radionerd/VirtualPipeOrgan/MidiFirmware/BlockDiagram.odt

USB Midi HID / Keyboard Serial 8 x 16 Matrix Scan Shift Reg I/F I2C ADC x 8 16x2 LCD Display 16x2 LCD Display Shift Register IF to Illuminated Pushbuttons 8 Op per s/r. 12 x s/r’s or More Scan up to 8 out x 16 in Diode Matrix for keyboard, Pedal board or Non-illuminated contacts Up to 8 Potentiometers for expression pedals and other analogue controls STM32F103C8T6 Blue Pill

Up to

8 Displays
