radionerd/VirtualPipeOrgan/ConsoleDrawings/PistonLabels.odt

This page is for printing onto a transparent sheet, cut labels to 12 x 12mm.

Div’n | 1 | 2 | 3 | 4 | 5 | 6 | 7 | 8 | 9 | 10 | 11 | 12 | 13 | 14
DISP. LHS | P/III | P / II | P / I | STEP -100 | STEP +100 | STEP -10 | STEP +10 | STEP +1 | STEP -1 | STEP xx0 | STEP xx1 | STEP xx2 | STEP xx3 | STEP xx4
DISP. RHS | STEP xx5 | STEP xx6 | STEP xx7 | STEP xx8 | STEP xx9 | | | | | STEP 000 | CURR -ENT | MUSIC STAND | PEDAL LAMP | SHIFT
III RHS SWELL | START REC | START PLAY | STOP REC | STOP PLAY | | | | | III/I | II/I | III/P | II/P | I/P | III/II
III LHS SWELL | Tutti | GEN 6 | GEN 7 | GEN 8 | GEN 9 | GEN 10 | 1 | 2 | 3 | 4 | 5 | 6 | 7 | 8
II LHS GREAT | | | | | | GEN 1 | GEN 2 | GEN 3 | GEN 4 | GEN 5 | 1 | 2 | 3 | 4
II RHS GREAT | 5 | 6 | 7 | 8 | | PREV | NEXT | | PED 6 | PED 7 | PED 8 | PED 9 | PED 10
I LHS CHOIR | SET | Metro nome On/Off | BBAR -1 | BBAR +1 | BPM +10 | BPM -10 | BPM -1 | BPM +1 | | | 1 | 2 | 3 | 4
I CHOIR POSITIV | 5 | 6 | 7 | 8 | GEN CAN | PAGE < | PAGE > | | PED 1 | PED 2 | PED 3 | PED 4 | PED 5 | GENERAL CANCEL

Keyboard Button Layout

Division | 1 | 2 | 3 | 4 | 5 | 6 | 7 | 8 | 9 | 10 | 11 | 12 | 13 | 14 | 15 | 16 | 17 | 18 | 19 | 20 | 21 | 22 | 23 | 24 | 25 | 26 | 27 | 28 | 29 | 30
18 | 7 Seg Display | | | LCD 1 | | | STEP +100 | STEP +10 | STEP +1 | STEP 000 | STEP XX0 | STEPXX1 | STEP XX2 | STEP XX3 | STEP XX4 | STEP XX5 | STEP XX6 | STEP XX7 | STEP XX8 | STEP XX9 | Curr-ent | Music Stand | Pedal Lamp | SHIFT | LCD 2 | | | LCD 3
SOLO/ BOMBARDE
III SWELL 19 | | | SHIFT | Wired to Disp 7 | Tutti | Wired to Disp 8 | BBAR +1 | BPM +10 | BPM +1 | Metro nome OnOff | | 1 | 2 | 3 | 4 | 5 | 6 | 7 | 8 | | | | III/I | II/I | III/P | II/P | I/P | III/II
II GREAT 21 | | | START REC | STOP REC | | GEN 6 | GEN 7 | GEN 8 | GEN 9 | GEN 10 | | 1 | 2 | 3 | 4 | 5 | 6 | 7 | 8 | | PREV | NEXT | | PED 6 | PED 7 | PED 8 | PED 9 | PED 10
I CHOIRPOSITV 22 | SET | | START PLAY | STOP PLAY | Wired to Set | GEN 1 | GEN 2 | GEN 3 | GEN 4 | GEN 5 | | 1 | 2 | 3 | 4 | 5 | 6 | 7 | 8 | | PAGE - | PAGE + | Wired to Genral Cancel | PED 1 | PED 2 | PED 3 | PED 4 | PED 5 | | Genral Cancel
PCB | 1 | | 1 | 2 | 3 | 4 | 5 | 6 | 7 | 8 | | 1 | 2 | 3 | 4 | 5 | 6 | 7 | 8 | | 1 | 2 | 3 | 4 | 5 | 6 | 7 | 8 | | 3?

Button Count

Display Panel 18+

Division III 20 = 5 shift registers

Division II 22 = 3 shift registers

Division I 24 = 3 shift registers

84 Buttons, 11 shift registers (4 unused button positions)
