radionerd/VirtualPipeOrgan/PCBs/MidiInterfaceAll/MidiInterface.jpg

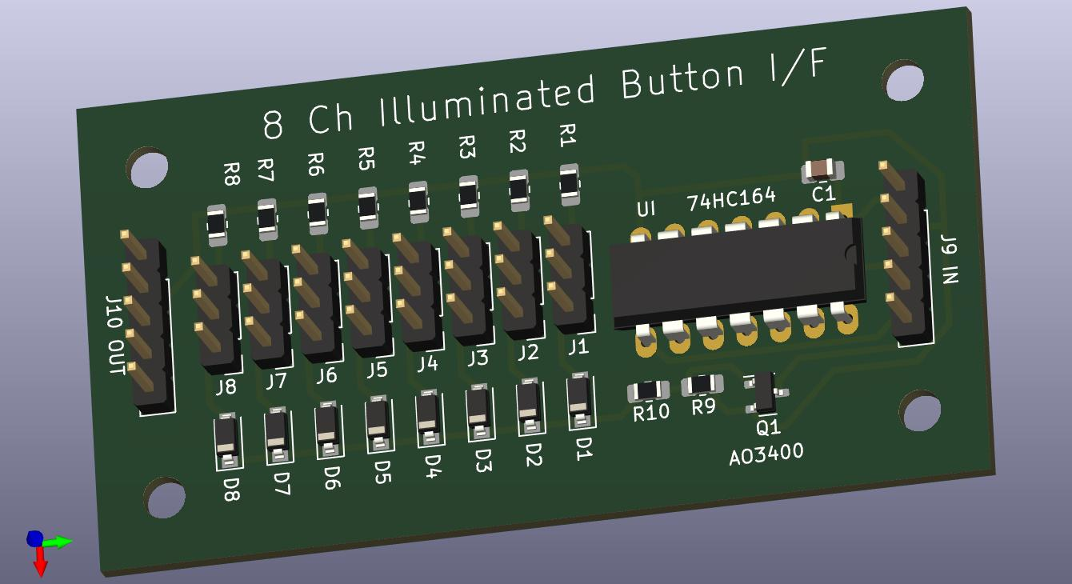
PCBs/MidiInterfaceAll/MidiInterface.jpg
