radionerd/VirtualPipeOrgan/ConsoleDrawings/test.dxf

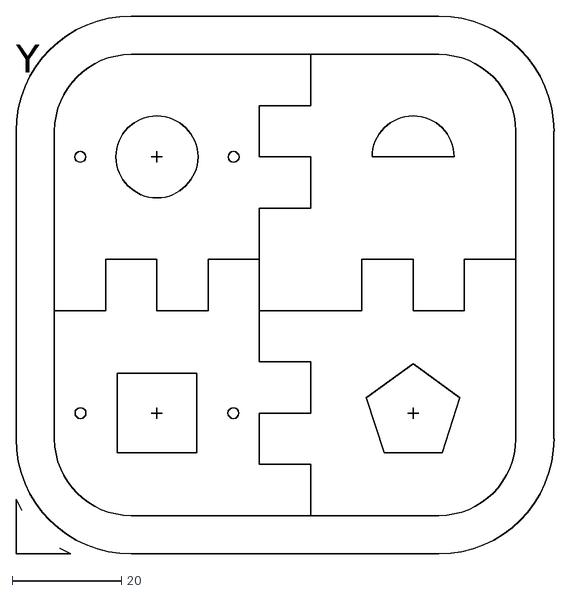
[picture p3: CAD file, 2025-04-20]
ConsoleDrawings/test.dxf
Y
