radionerd/VirtualPipeOrgan/ExpressionPedal/Foot Pedal Geometry.dxf

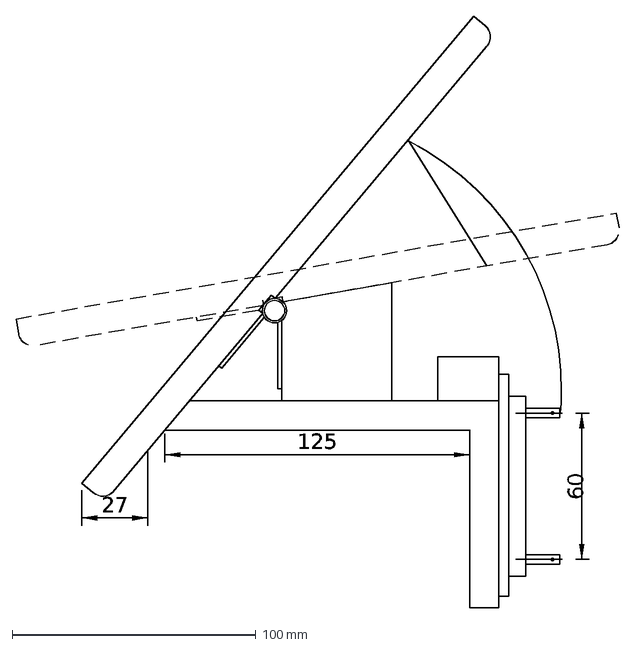
[picture p4: CAD file, 2025-04-21]
ExpressionPedal/Foot Pedal Geometry.dxf
60
125
27
