radionerd/VirtualPipeOrgan/ConsoleDrawings/musicStand.dxf

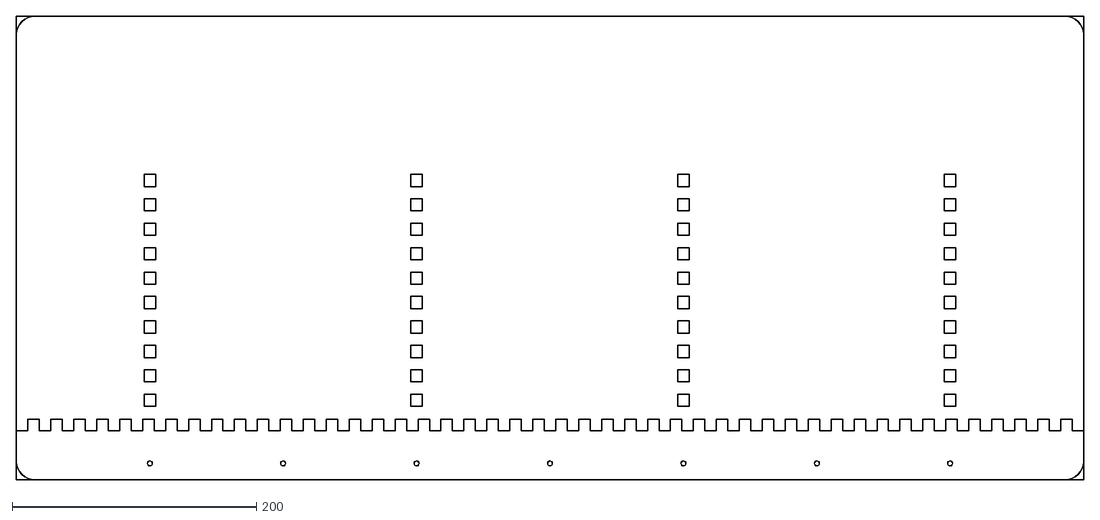
[picture p5: CAD file, 2025-04-20]
ConsoleDrawings/musicStand.dxf
873.7 x 379.4
