radionerd/VirtualPipeOrgan/ExpressionPedal/Foot Pedal Drilling and Cutting.dxf

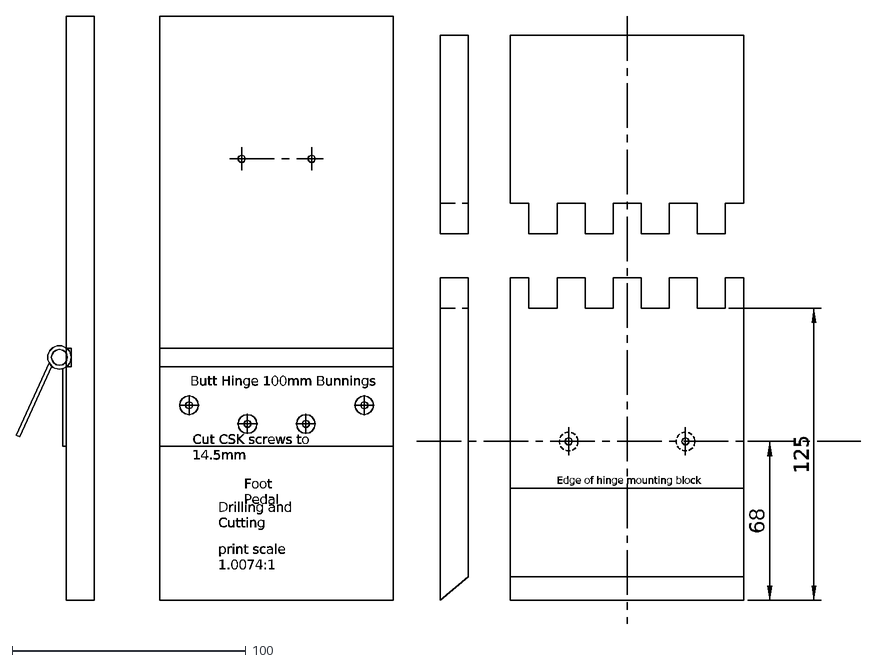
[picture p6: CAD file, 2025-04-21]
ExpressionPedal/Foot Pedal Drilling and Cutting.dxf
Butt Hinge 100mm Bunnings
Foot Pedal
print scale 1.0074:1
Cut CSK screws to 14.5mm
Drilling and Cutting
Edge of hinge mounting block
68
125
