radionerd/VirtualPipeOrgan/ConsoleDrawings/trayIII.dxf

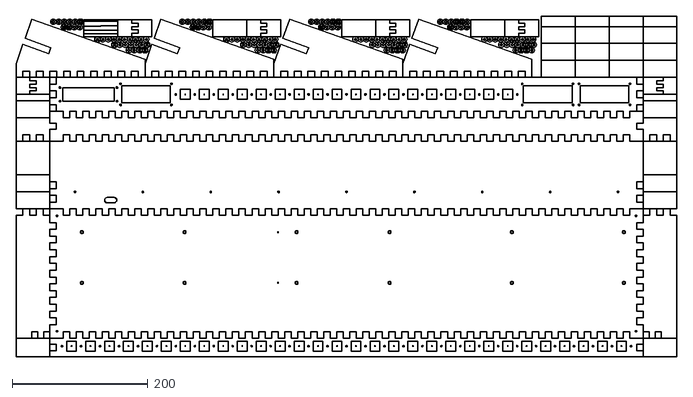
[picture p7: CAD file, 2023-09-29]
ConsoleDrawings/trayIII.dxf
973.7 x 501.4
