radionerd/VirtualPipeOrgan/ExpressionPedal/#PrototypeJig.dxf

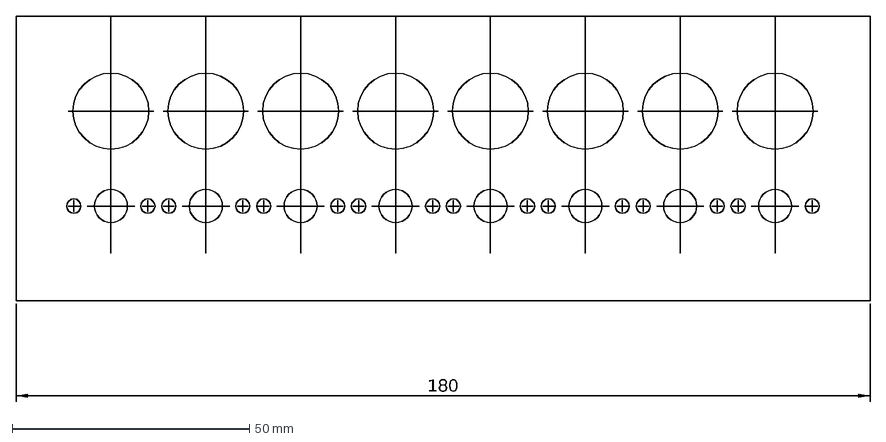
[picture p8: CAD file, 2025-04-21]
ExpressionPedal/#PrototypeJig.dxf
180
