radionerd/VirtualPipeOrgan/ConsoleDrawings/trayII.dxf

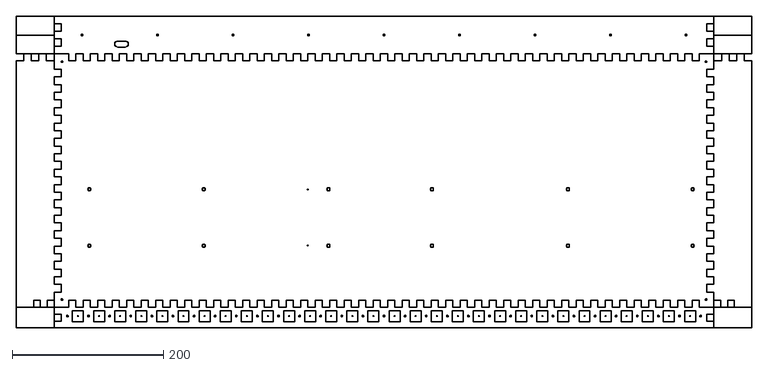
[picture p9: CAD file, 2023-09-29]
ConsoleDrawings/trayII.dxf
973.7 x 412.7
