radionerd/VirtualPipeOrgan/ConsoleDrawings/trayI.dxf

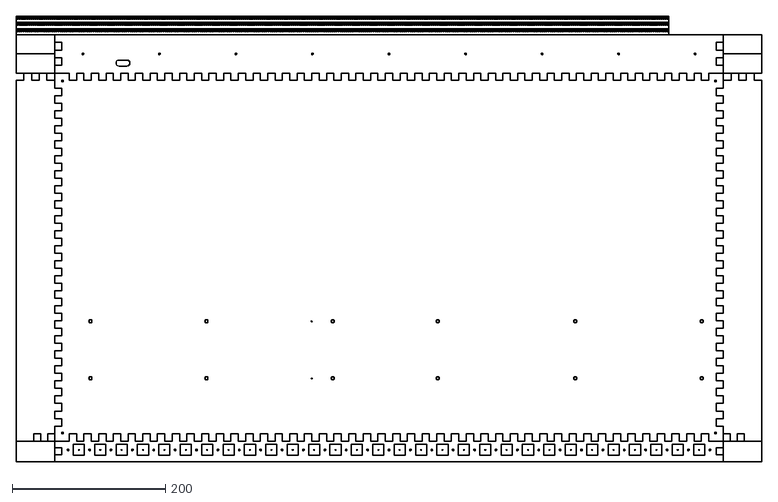
[picture p10: CAD file, 2023-09-29]
ConsoleDrawings/trayI.dxf
973.7 x 581.9
