radionerd/VirtualPipeOrgan/ConsoleDrawings/tray444.dxf

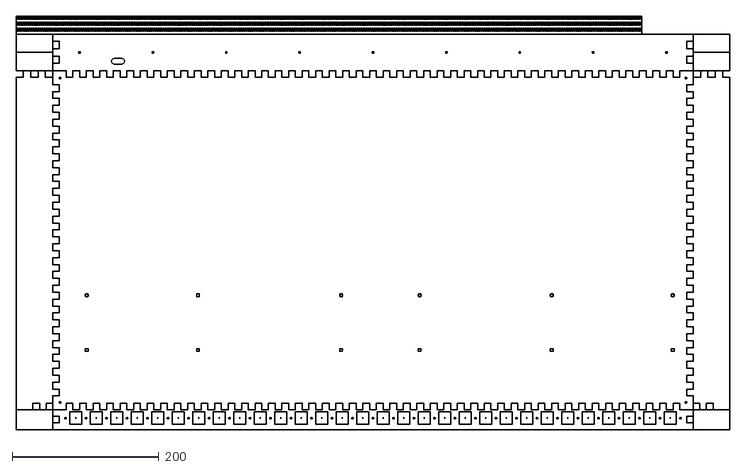
[picture p11: CAD file, 2023-08-24]
ConsoleDrawings/tray444.dxf
973.0 x 563.2
