radionerd/VirtualPipeOrgan/(list of files, cad)

Other CAD files:
ExpressionPedal/PrototypeJig.dxf
