radionerd/VirtualPipeOrgan/MidiFirmware/UserManual.md

# USB MIDI Interface User Manual

This user manual uses Linux OS examples with Grandorgue. For other Operating Systems and Applications similar commands will exist. 

The user manual assumes that you have programed the flash in the STM32 Bluepill using the instructions in [README.md](https://github.com/radionerd/VirtualPipeOrgan/blob/main/MidiFirmware/README.md)

## Features
- Hosted on the Arm Cortex-M3 CPU STM32F103C8T6 Bluepill, a ~$2 US development board
- USB Connection to host computer, LED blink on MIDI activity
- Multiple STM32 boards may be deployed to ease wiring
- Scanning for MAudio Keystation 61 Keyboard or 32 note pedalboard
- Up to 4 ADC inputs when configured for a keyboard without velocity sensing
- Up to 8 ADC inputs for expression pedals when scanning a pedalboard
- 64 LED illuminated button inputs using external 74HC164 shift registers
- One 6 digit LED display per MIDI controller (for combination setter & crescendo display)
- Multiple Liquid Crystal Display modules 16x2 line PCF8574 I2C interface ( 8 per IC type )
- Interface to WS2812 RGB LED string for music stand or pedal illumination
- USB HID (qwerty keyboard) messages for music page turning
- Simulated serial interface over USB for viewing/saving configuration in Flash
- Tested using Arduino V1.8.19 with STM32 extensions under Ubuntu 24.04 X86 & Arm Linux
- Printed circuit boards to mount the STM32 Bluepill and shift register interfaces use low cost plug in cables to simplify wiring

## The USB Connection

To discover whether the MIDI interface is successfully connected to the computer type 'lsusb' at the command prompt. The MIDI interfaces and the configured MIDI channel numbers for keyboard/pedalboard, and the illuminated buttons should show up in the response. e.g:
```
$ lsusb
   ...
   Bus 001 Device 094: ID 1eaf:0031 Leaflabs VPO Console MIDI Ch3, 11
   Bus 001 Device 095: ID 1eaf:0031 Leaflabs VPO Console MIDI Ch4, 12
   ...
```

## MIDI Channel Assignment

MIDI channels for keyboard/pedalboard are configurable from 1-8 with the illuminated button channel offset by 8.

e.g. If the pedalboard MIDI channel is set to 4, then the Button MIDI channel will be 4 + 8 = 12.

## MIDI Messages

|  Control |Chan| MIDI Message  | Direction |
|:---:|:--:|:---:|:---:|
| Keyboard |1-8 | MIDI Note 32-96 | To Comp |
| Pedalboard |1-8 | MIDI Note 32-64 | To Comp |
| Expression |1-8 | MIDI CC 20-27 | To Comp |
| Buttons |9-16| MIDI Note 0-127 | To Comp |
| Button LEDs|9-16| MIDI Note 0-127 | From Comp |
| LED 7Seg |N/A | SysexID as KChan| From Comp |
| LCD Display|N/A | MIDI Sysex 32-63| From Comp |

ID addresses are shown on the LCD and 7 Segment LED displays after power up.

### Power Up

At power up the MIDI interface loads the 7 Segment display, LCDs with the 'PC Comms' message and lights the Push Button LEDs until PC communication is established over the USB. Then the displays are loaded to show their configured addresses. The 7 Segment Display configured address is the same as the MIDI channel number. 

|  State | 7Seg Text  | LCD Text | LED Push Buttons  |Built In LED  |
|:---:|:---:|:---:|:---:|:---:|
|Power On  | PC ??? | PC Comms ??? | All Lit | Flash |
|PC Success|  Add= 3 |VirtualPipeOrgan| Light When Pressed|Breathing .5Hz|
| " " | |i2cAddr=37  0x25| | ADC Toggle |
|GrandOrgue| GO | GO | GO | Note: On/Off |

The MIDI Interface LED will flash during initialisation. When communication with the PC is established the MIDI Interface LED will slowly get brigter and dimmer at approx 0.5Hz to show that all is well.

When Keyboard or Push button are pressed or released the MIDI Interface LED will turn on of off in sync, and resume 0.5Hz breathing after 5 seconds of inactivity. The Builtin LED also toggles on or off when MIDI CC messages are sent by the ADC.

Until GranOrgue is running push button LEDs illuminate when pressed as a button and LED test feature.

Once GrandOrgue is running the push button LEDs may be loaded by GrandOrgue MIDI note on or MIDI note off messages, the value field 0-127 is ignored.

# Monitoring MIDI Messages on the PC
Use 'midisnoop' to monitor messages sent between the keyboard/pedalboard and the computer. Select Alsa unless you have Jack configured.
```
$ midisnoop &
```
MIDI messages may also be monitored within the MIDI Interface using the 'J' command (see below).

# Making MIDI Connections
Use 'qjackctl' graph function to view or connect MIDI outputs to MIDI inputs.

This works for ALSA and JACK.

```
$ qjackctl &
```
At startup GrandOrgue makes its required MIDI connections to the MIDI keyboards.

You may need to re-esatblish connections manually if you restart the STM32 Bluepill.

Connect the Grandorgue output to VPO Console and midisnoop inputs using the qjacktctl graph feature and mouse.

Connect the VPO Console output to Grandorgue and midisnoop inputs using the qjacktctl graph feature and mouse.

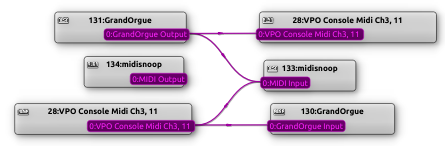
[picture p12: MidiFirmware/MidiSnoopGOExample.png]


Alternatively edit and run the [autoconnect](https://github.com/radionerd/VirtualPipeOrgan/blob/main/MidiFirmware/autoconnect) script in background.

## Configuring the Firmware
A simulated USB serial connection is used to communicate with the MIDI Interface.
Connect one STM32 BluePill to the computer using a USB cable.
Install 'minicom' and configure it to connect to /dev/ttyACM0 or /dev/ttyUSB0 depending on your OS.
( Exit minicom by typing CTRL+A Z Q <Enter> )
To confirm that you have the expected MIDI channel and tty device run the command:
```
 $ ll /dev/serial/by-id/
total 0
drwxr-xr-x 2 root root 80 Jun  1 13:53 ./
drwxr-xr-x 4 root root 80 Jun  1 13:53 ../
lrwxrwxrwx 1 root root 13 Jun  1 13:53 usb-New_Zealand_VPO_Console_Midi_Ch3__11_00001-if02 -> ../../ttyACM1
lrwxrwxrwx 1 root root 13 Jun  1 13:53 usb-New_Zealand_VPO_Console_Midi_Ch4__12_00001-if02 -> ../../ttyACM0

```
Once connected successfully expand the minicom window and press the spacebar.
You should see a display that shows which pin functions are assigned.
Configure what you require using the A-J keys, then press 'S' to save.
```
STM32 Blue Pill Assigned Pin Functions
IP_SR_DATA    PB12   USB   GND    
Scan In  0    PB13         GND    
Spare         PB14         3V3    
Scan In  2    PB15         NRST   
Spare         PA_8         PB11   OP_SR_CLOCK
Scan In  4    PA_9         PB10   TM1637_CK
Spare         PA10         PB_1   Scan In  8
USB-          PA11         PB_0   IP_ADC  6
USB+          PA12         PA_7   Scan In  a
Scan In  6    PA15         PA_6   IP_ADC  4
Spare         PB_3         PA_5   Scan In  c
Scan Out 4    PB_4         PA_4   IP_ADC  2
Scan Out 5    PB_5         PA_3   Scan In  e
LCD  I2C_SCL  PB_6         PA_2   IP_ADC  0
ShareI2C_SDA  PB_7         PA_1   Scan Out 3
Scan Out 6    PB_8         PA_0   Scan Out 2
Scan Out 7    PB_9         PC15   Scan Out 1
               +5V         PC14   Scan Out 0
               GND         PC13   OP_LED
               3V3 | | | | VBAT   
                   | | | |
WS2812 LEDs   PA13---+ +---PA14   HID PageTurn
BOOT1         PB_2 (on Jumper via 100K resistor)

Configuration Menu
A [3] Key/Pedal MIDI Channel=3, Button channel=11
B [ ] Pedalboard
C [4] Number of ADC Inputs PA2-PB1
D [ ] Keyboard/Pedalboard Velocity Reporting
E [✓] PCF8574 I2C LCDs 16x2 Line
F [✓] TM1637 7 segment, 6 digit display
G [1] 74HC164 Button LED Normal+Backlight
H [✓] Page Turning
I [✓] WS2812 RGB LED Strip
J [ ] Event Log to USB Serial (may slow response time)
Cfg.Word=CE42
Enter A-L,a-l To adjust cfg value, S to Save, ? - Menu:
```
The event log 'J' command is useful to monitor MIDI messages being sent to the computer. However
using the event log may slightly slow down performance and so should not be enabled during normal use.

# MIDI Interface Menu

To monitor activity on attached devices type '?' to view the MIDI interface menu.
```
MIDI Interface Menu
@ - or spacebar to View Configuration
A-J Adjust configuration value
K - Keyboard Contacts
L - LCD 'l'=view, 'L'=load
M - Flash memory summary
O - Shift Register IO
P - Profile
R - Restore Configuration
S - Save New Configuration
T - Test IO Pins
U - USB HID Page Turn Input
V - Version Info
W - WS2812 LED Strip
X - eXpression Pedal / ADC results
Z - Pin Status
```
Single letter commands are used to configure the MIDI interface and to view the status of connected hardware. The the configuration has been changed the 'S' Save command should be used to store the new configuration in Flash memory.

### MIDI Channel Selection

The 'A' command is used to select select the MIDI keyboard channel 1-8 and the corresponding LED Button channel offset by 8.

### Keyboard or Pedalboard

The MAudio Keystation 61 note keyboard connectors are accomodated directly on the PCBs.
The keyboard provides two contacts per note for velocity sensing between the time that the first and second contact operates or releases.
When Velocity sensing is not required, four unused inputs become available for ADC/Expression inputs if required.
When pedalboard operation is selected the same keyboard note assignments are used, so the MAudio Keystation may be used to emulate a pedalboard for testing.

The 'B' command toggles  between Keyboard or Pedboard configuration. The 'D' command enables/disables velocity sensing.

### 'K' Keyboard scan result.
The MAudio Keystation 61 Mk3 music keyboard has two contacts per key to sense velocity. Keyboard scanning uses 8 outputs and 16 inputs. When pedalboard is selected the top 8 keyboard input lines are re-assigned to be used as expression pedal (ADC) inputs. The pedalboard scans 32 contacts using 8 outputs and 8 inputs. Alternate inputs are unused when there is no velocity sensing.
```
Keyboard Scan Result MIDI Channel 3

0000000000000000 OP0  CN13 PIN4
0000000000000000 OP1  CN13 PIN3
0000000000000000 OP2  CN13 PIN2
0000000000000000 OP3  CN13 PIN1
0000000000000000 OP4  CN14 PIN4
0000000000000000 OP5  CN14 PIN3
0000000000000000 OP6  CN14 PIN2
0000000000000000 OP7  CN14 PIN1
........******** IP *=CN13 input pins 5-6,7=nc,8-13
********........ IP *=CN14 input pins 5-12
```
When the keyboard contacts are operating correctly use the 'J' command to check the MIDI messages being sent to the PC.

## Liquid Crystal Displays

The LCDs use PCF8574 based I2C to parallel adapters.



The PCF8574 and PCF8574A ICs on LCD displays use two different address ranges.

Unless you need more than 8 displays it does not matter which kind you buy or whether they are mixed.

|  PCF8574 | Grandorgue | PCF8574A | Grandorgue | A2| A1| A0|
|:---:|:---:|:---:|:---:|:-:|:-:|:-:|
| 0x20 | 32 | 0x38 | 56 | 0 | 0 | 0 |
| 0x21 | 33 | 0x39 | 57 | 0 | 0 | 1 |
| 0x22 | 34 | 0x3a | 58 | 0 | 1 | 0 |
| 0x23 | 35 | 0x3b | 59 | 0 | 1 | 1 |
| 0x24 | 36 | 0x3c | 60 | 1 | 0 | 0 |
| 0x25 | 37 | 0x3d | 61 | 1 | 0 | 1 |
| 0x26 | 38 | 0x3e | 62 | 1 | 1 | 0 |
| 0x27 | 39 | 0x3f | 63 | 1 | 1 | 1 |

The ID adddresses configured in GrandOrgue are Base 10.

- User solder bridges A0-A2 are used to program zeros and are binary coded. So the default address without any solder bridges is is either 0x27 (39) or 0x3F (63).

The content of the LCD messages may be viewed with the 'l" command, and LCDs may be loaded with the 'L' command.

## Seven Segment, Six Digit LED Display



Some TM1637 LED Display modules ship with excessively large value filter capacitors on Data and Clock inputs. The capacitors not only prevent the seven segment display updates, but also disrupt I2C LCD Display and button shift register operation. If fitted, these filter capacitors need to be either removed or significantly reduced in value.

The 'l' Command also displays the status of the Seven Segment TM1637 LED display.

```
LCD Display List                                                                
Dec  Hex Text                                                                   
 03 0x03 [Add=3 ][]                                                             
 37 0x25 [VirtualPipeOrgan][i2cAddr=37  0x25]                                   
 62 0x3E [VirtualPipeOrgan][i2cAddr=62  0x3E]                                   
 63 0x3F [VirtualPipeOrgan][i2cAddr=63  0x3F]                                   
```

### 'M' Flash Memory Summary
Not really a user feature.  Provided for testing the 'S'ave command.
```
Flash Memory Summary

0800C850 0000 0000 0000 0000 0000 0000 A678 0800
0800C860 FFFF FFFF FFFF FFFF FFFF FFFF FFFF FFFF
...
0801F7F0 FFFF FFFF FFFF FFFF FFFF FFFF FFFF FFFF
0801F800 DEAD 7F58 0000 1000 1E00 1E01 1E03 1E02
...
0801F820 BE72 3E12 3E02 FFFF FFFF FFFF FFFF FFFF
0801F830 FFFF FFFF FFFF FFFF FFFF FFFF FFFF FFFF
...
```
### LED Illuminated Push Buttons

LED lluminated push buttons are connected via 74HC164 shift registers. LEDs may be configured by the 'G' command to light normally or inverse and to have a dim backlight which is useful for reading the button legends in a dim environment.

When the MIDI interface powers up all LEDs light briefly as a lamp test feature.

Until the MIDI Interface connects to GrandOrgue each button will illuminate when pressed for testing the button and LED operation.

Once GrandOrgue is running the push button LEDs may be loaded by GrandOrgue 'MIDI note on' or 'MIDI note off' messages, the value field 0-127 is ignored.

Buttons generate MIDI note messages on the configured keyboard MIDI channel plus 8.

The first button (00) in the series acts as a shift key. When button 00 is held in, any other button pressed generates its MIDI note +64. The shift feature may be used to economise on the number of console buttons. For example a '+1' button may be configured to act as '-1' when shift is pressed.

When a button is held for longer than 4 seconds its MIDI note is set to auto repeat at 0.5 second intevals. Auto repeat may be useful for adjusting the metronome tempo.

The status of the connected shift registers may be seen with the 'O' command.

```
Shift Register MIDI Channel 12 Note Numbers

SR 1   00  i01o  02   03   04   05   06   07  
SR 2   08   09   10   11   12   13   14   15  
SR 3   16   17   18   19   20   21   22   23  
SR 4   24   25   26   27   28   29   30   31  
SR 5   32   33   34   35   36   37   38   39  
SR 6   40   41   42   43   44   45   46   47  
SR 7   48   49   50   51   52   53   54   55  
SR 8   56   57   58   59   60   61   62   63  

i = input on, o = output on
```
The power 'ON' indicator of the GrandOrgue 'Master Controls' panel may be configured with a mouse right click to send the power on status the the shift button (MIDI-note 0) LED. In this way it can be seen at a glance when the organ is ready to play.

### Profile

The 'P' command displays the execution times in microseconds of different features in use. This is a development feature to ensure that the system is always responsive with no excessive time delays. Lower case 'p' displays executions times, upper case 'P' clears the recorded times to zero.
```
Times in microseconds

   Count Interval AvgTime MaxTime  Feature
  344903     1001      59     116  Music Keyboard
   34491    10000       2    7645  SerialUI
   34490    10000       3       9  ADC
   34490     9999     541     624  Buttons
   34490    10002       6       8  HID PageTurn
   34490    10000       3    5014  MIDI Poll
   34490    10000       5    1698  WS2812 LED Strip
      15     9594      87    4511  Sysex
       1  9999999    1369    1369  MIDI Out to SysEx In
  344902      999      63    7711  Loop
       8  9999999    2032    2083  This Print
       0        0       0       0  Spare
```
It seems as though MIDI send execution times are longer when GrandOrgue is not connected.

The profile feature was used in conjunction with an oscillscope to reduce execution times by :

- Coding direct GPIO access in lieu of Arduino GPIO ( making the firmware much less portable )
- Keyboard and Button scanning using STM32 Bit-Banding
- Active pull down of keyboard scan lines ( briefly driving active inputs low rather than using pull down resistors )
- Sending only changes to LCD displays ( the largest saving of all 40+ms to sub millisecond in some cases )

Execution times for WS2812 LED strips are incorrect, as one timer interrupt is missed during loading.

### Test GPIO Pins

the 'T' command provides a simple check that each GPIO pin may be briefly driven high and low and read back correctly. It can by handy to isolate faulty boards.

### Page Turning

The page turning feature is intended to control the display of music shown on the computer monitor using a pdf file viewer such as Evince.

The page turning feature uses the USB Human Interface Device (HID) protocol and appears to the PC as a keyboard.

The MIDI interface sends four QWERTY keyboard commands on the USB cable from a single switch depending on how the switch is pressed. The MIDI interface simulates the pressing of keys, just as though they were entered on the computer keyboard. Page turning will be successful when the file viewer has focus and responds appropriately to the 'Page Up', 'Page Down', 'Home' and 'End' keys.

eg To send 'Page down' one short press.
eg To send 'Home' long press after single presses.
eg To go back one page, two short presses.
A single press followed by a long press will scroll through the entire document forwards.
A double press followed by a long press will scroll through the entire document backwards.

| Short Count | Short Press |  Long Press | Long Repeat |
|:---:|:---:|:---:|:---|
| 1 |  Page Down  |  Ctrl+Home  |  Page Down  |
| 2 |  Page Up |  Ctrl+End |  Page  Up |

On a good day single short and long presses should be sufficient to work through the music and go back to the beginning.

An off the shelf sustain pedal may make a useful page turning switch.

The page turning switch is attached between 0v and PA14 located on the Debug/Programming connector.

Page turning is configured using the 'H' and 'S' commands, and its status viewed using the 'U' command.

<mark> Note ! </mark> When using the Virtual Serial Port and minicom with the USB HID Page turn feature remember to move the PC window focus away from minicom to, for example, a pdf file viewer. Otherwise minicom will respond to the page control commands.

Page Turning execution time is 20ms for Page Down, and 40ms for Page Up. So turning pages may very slightly delay keyboard notes.

### Version Info

The Version number and compilation date are reported with the 'V' command. e.g.

```
V0.9.1 Jun 15 2025 21:08:47
```

### ADC & Expression Pedals

Up to 8 ADC inputs may be configured for Expression Pedals when the Pedalboard option is selected.

Up to 4 ADC inputs may be configured for Expression Pedals when the Keyboard option is selected without velocity sensing.
Select the number of ADC convertors to use using the 'C' command.
Note. ADC inputs are connected to potentiometers wired between 0v and 3.3V with a 470R resistor connected between the wiper and the MIDI interface input pin. 
Enabling A->D conversion without any connected input may generate large amounts of meaningless MIDI CC messages slowing down the system.

On GrandOrgue right click on the expression pedal input. 

Click 'Event' and select Bx Controller

Click 'Channel' select your configured MIDI channel

Click 'Detect Complex MIDI Setup', move the Expression Pedal control as directed.
Note: The MIDI interface generates CC messages in the range 20-27

Click 'OK' and remember to save the organ settings

Use the 'X' command to view the Expression pedal status. e.g.
```
Expression Pedal/ADC Results
    ADC   AVG   REP MIDICh CCommand
0  2592  2589    80     4    20
2   161   155     4     4    22
4   160   157     4     4    24
6   150   157     4     4    26
```

### WS2812 LED strip

The LED feature is intended for illuminating music stands and pedalboards.

The LED strip is controlled by pressing the lowest C# on the MIDI controller to which the LED strip is connected. The C# is only active for LED control when no other notes have been active for the previous 5 seconds. The number of key presses will trigger different functions

| | Short Press | Long Press |
|:-:|:---:|:---:|
| 1 | Toggle On/Off |Brightness  |
| 2 | Rainbow mode  |Colour(Hue) |
| 3 | |Saturation  |

Strips up to 60 LEDs in length are supported. 

### WS2812 LED Strip Control

The LED Strip control is intended to be used for illuminating the music stand and pedalboard, or just for decoration.

The WS22812 LED strip is configured (enabled/disabled) using the 'I' command. The status of the LED strip may be viewed with the 'W' command.

The LED strip is controlled using the lowest C# of the keyboard to which it is attached, when no other key activity has been present for 5 seconds or more. The number of times and duration that the C# is pressed determines the brightness, hue and saturation of the LED strip.

|Short Press | Long Press |
|:---:|:---:|
| 1 - On/Off | Brightness |
| 2 - Rainbow| Hue |
| 3 - Unused | Saturation |

### 'Z' Pin Status

This screen is provided to view the internal pin assignements and may be useful for viewing the 12 bit ADC results before filtering and conversion to 7 bit MIDI values. e.g.:
```
USB MIDI Interface Status
id  port   function     kbd  count input error fault
 0  VBAT                 0     0     0     0    ' ' 
 1  PC13       OP_LED    0     0     0     0    ' ' 
 2  PC14   Scan Out 0    0     0     0     0    ' ' 
 3  PC15   Scan Out 1    0     1     0     0    ' ' 
 4  PA_0   Scan Out 2    0     2     0     0    ' ' 
 5  PA_1   Scan Out 3    0     3     0     0    ' ' 
 6  PA_2    IP_ADC  0    0     0    e0    e0    ' ' 
 7  PA_3    IP_ADC  1    0     1   36e   37a    ' ' 
 8  PA_4    IP_ADC  2    0     2   509   51e    ' ' 
 9  PA_5    IP_ADC  3    0     3   749   75c    ' ' 
10  PA_6    IP_ADC  4    0     4   8b4   8a1    ' ' 
11  PA_7    IP_ADC  5    0     5   8d8   8c0    ' ' 
12  PB_0    IP_ADC  6    0     6   a59   a43    ' ' 
13  PB_1    IP_ADC  7    0     7   e10   e1b    ' ' 
14  PB10    TM1637_CK    0     0     0     0    ' ' 
15  PB11  OP_SR_CLOCK    0    60     0     0    ' ' 
16  NRST                 0     0     0     0    ' ' 
17   3V3                 0     0     0     0    ' ' 
18   GND                 0     0     0     0    ' ' 
19   GND                 0     0     0     0    ' ' 
20  PB12   IP_SR_DATA    0     0     0     0    ' ' 
21  PB13   Scan In  0    0     0     0     0    ' '
22  PB14   Scan In  1    0     1     0     0    ' ' 
23  PB15   Scan In  2    0     2     0     0    ' ' 
24  PA_8   Scan In  3    0     3     0     0    ' ' 
25  PA_9   Scan In  4    0     4     0     0    ' ' 
26  PA10   Scan In  5    0     5     0     0    ' ' 
27  PA11         USB-    0     0     0     0    ' ' 
28  PA12         USB+    0     0     0     0    ' ' 
29  PA15   Scan In  6    0     6     0     0    ' ' 
30  PB_3   Scan In  7    0     7     0     0    ' ' 
31  PB_4   Scan Out 4    0     4     0     0    ' ' 
32  PB_5   Scan Out 5    0     5     0     0    ' ' 
33  PB_6 LCD  I2C_SCL    0     0     0     0    '!' 
34  PB_7 ShareI2C_SDA    0     0     0     0    '!' 
35  PB_8   Scan Out 6    0     6     0     0    ' ' 
36  PB_9   Scan Out 7    0     7     0     0    ' ' 
37   +5V                 0     0     0     0    ' ' 
38   GND                 0     0     0     0    ' ' 
39   3V3                 0     0     0     0    ' ' 
40  PA13  WS2812 LEDs    0     0     0     0    ' ' 
41  PA14  WS2812 LEDs    0     0     0     0    ' ' 
42  PB_2        BOOT1    0     0     0     0    ' ' 

```

### SignOff

Congratulations on having read this far.
Let me know via github if you have suggestions for enhancements.

Richard Jones
15th June 2025
