radionerd/VirtualPipeOrgan/PCBs/PCMountButtonDriver/PCMountButtonDriver.kicad_pcb

## KiCad design PCBs/PCMountButtonDriver/PCMountButtonDriver.kicad_pcb (2023-09-30)

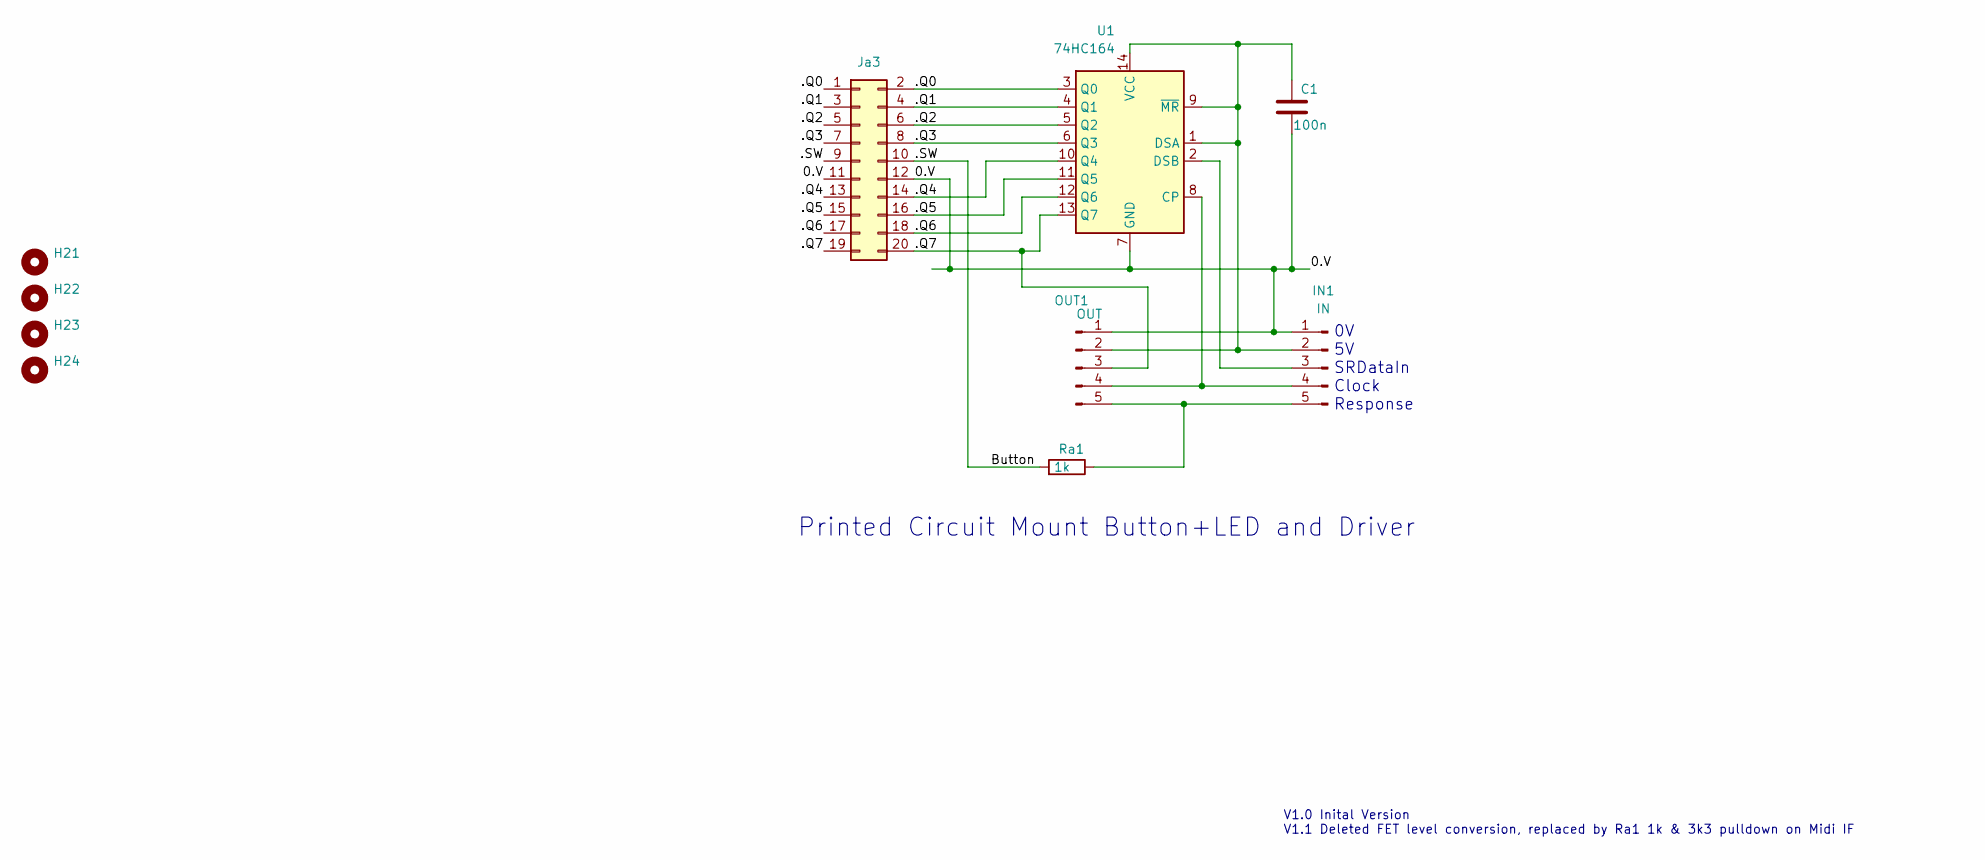
[picture p13: schematic PCMountButtonDriver.kicad_sch]

Parts:
C1: 100n; C_0805_2012Metric_Pad1.18x1.45mm_HandSolder
H21, H22, H23, H24: MountingHole; MountingHole_3.2mm_M3
IN1: IN; PinHeader_1x05_P2.54mm_Vertical
Ja3: Conn_02x10_Odd_Even; PinHeader_2x10_P2.54mm_Vertical
OUT1: OUT; PinHeader_1x05_P2.54mm_Vertical
Ra1: 1k; R_0805_2012Metric_Pad1.20x1.40mm_HandSolder
U1: 74HC164; DIP-14_W7.62mm_LongPads

Connections:
/0.V: C1.2, IN1.1, Ja3.11, Ja3.12, OUT1.1, U1.7 (GND)
/.Q0: Ja3.1, Ja3.2, U1.3 (Q0)
/.Q1: Ja3.3, Ja3.4, U1.4 (Q1)
/.Q2: Ja3.5, Ja3.6, U1.5 (Q2)
/.Q3: Ja3.7, Ja3.8, U1.6 (Q3)
/.Q4: Ja3.13, Ja3.14, U1.10 (Q4)
/.Q5: Ja3.15, Ja3.16, U1.11 (Q5)
/.Q6: Ja3.17, Ja3.18, U1.12 (Q6)
/.Q7: Ja3.19, Ja3.20, OUT1.3, U1.13 (Q7)
/.SW: Ja3.9, Ja3.10, Ra1.2
unnamed: C1.1, IN1.2, OUT1.2, U1.1 (DSA), U1.9 (~MR), U1.14 (VCC)
unnamed: IN1.3, U1.2 (DSB)
unnamed: IN1.4, OUT1.4, U1.8 (CP)
unnamed: IN1.5, OUT1.5, Ra1.1

Notes on the sheet:
V1.0 Inital Version V1.1 Deleted FET level conversion, replaced by Ra1 1k & 3k3 pulldown on Midi IF
Printed Circuit Mount Button+LED and Driver
0V 5V SRDataIn Clock Response

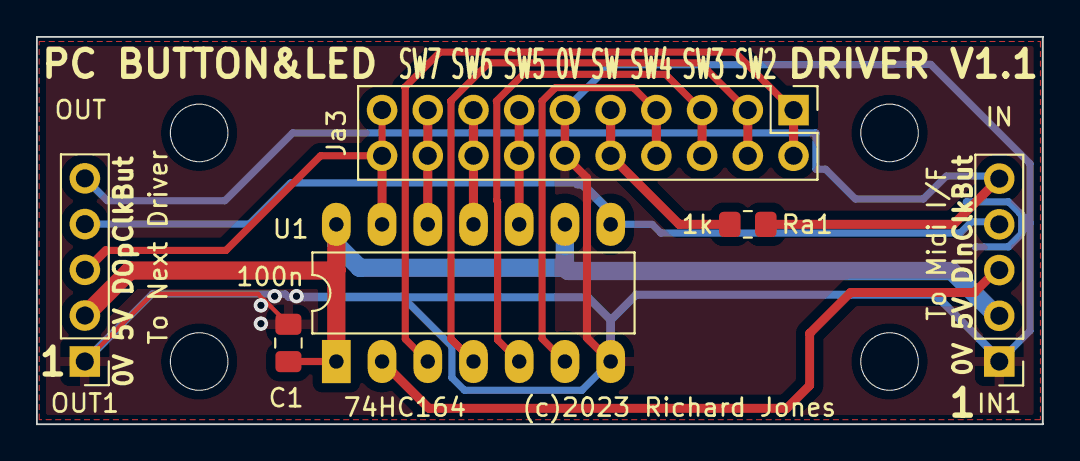
[picture p14: board PCMountButtonDriver.kicad_pcb from above]

Board: 2 copper layers, 55.9 x 21.5 mm, 10 parts (0 on the bottom side), 14 nets.
