radionerd/VirtualPipeOrgan/PCBs/MidiInterfaceKS61/MidiInterfaceKS61.kicad_pcb

## KiCad design PCBs/MidiInterfaceKS61/MidiInterfaceKS61.kicad_pcb (2023-09-30)

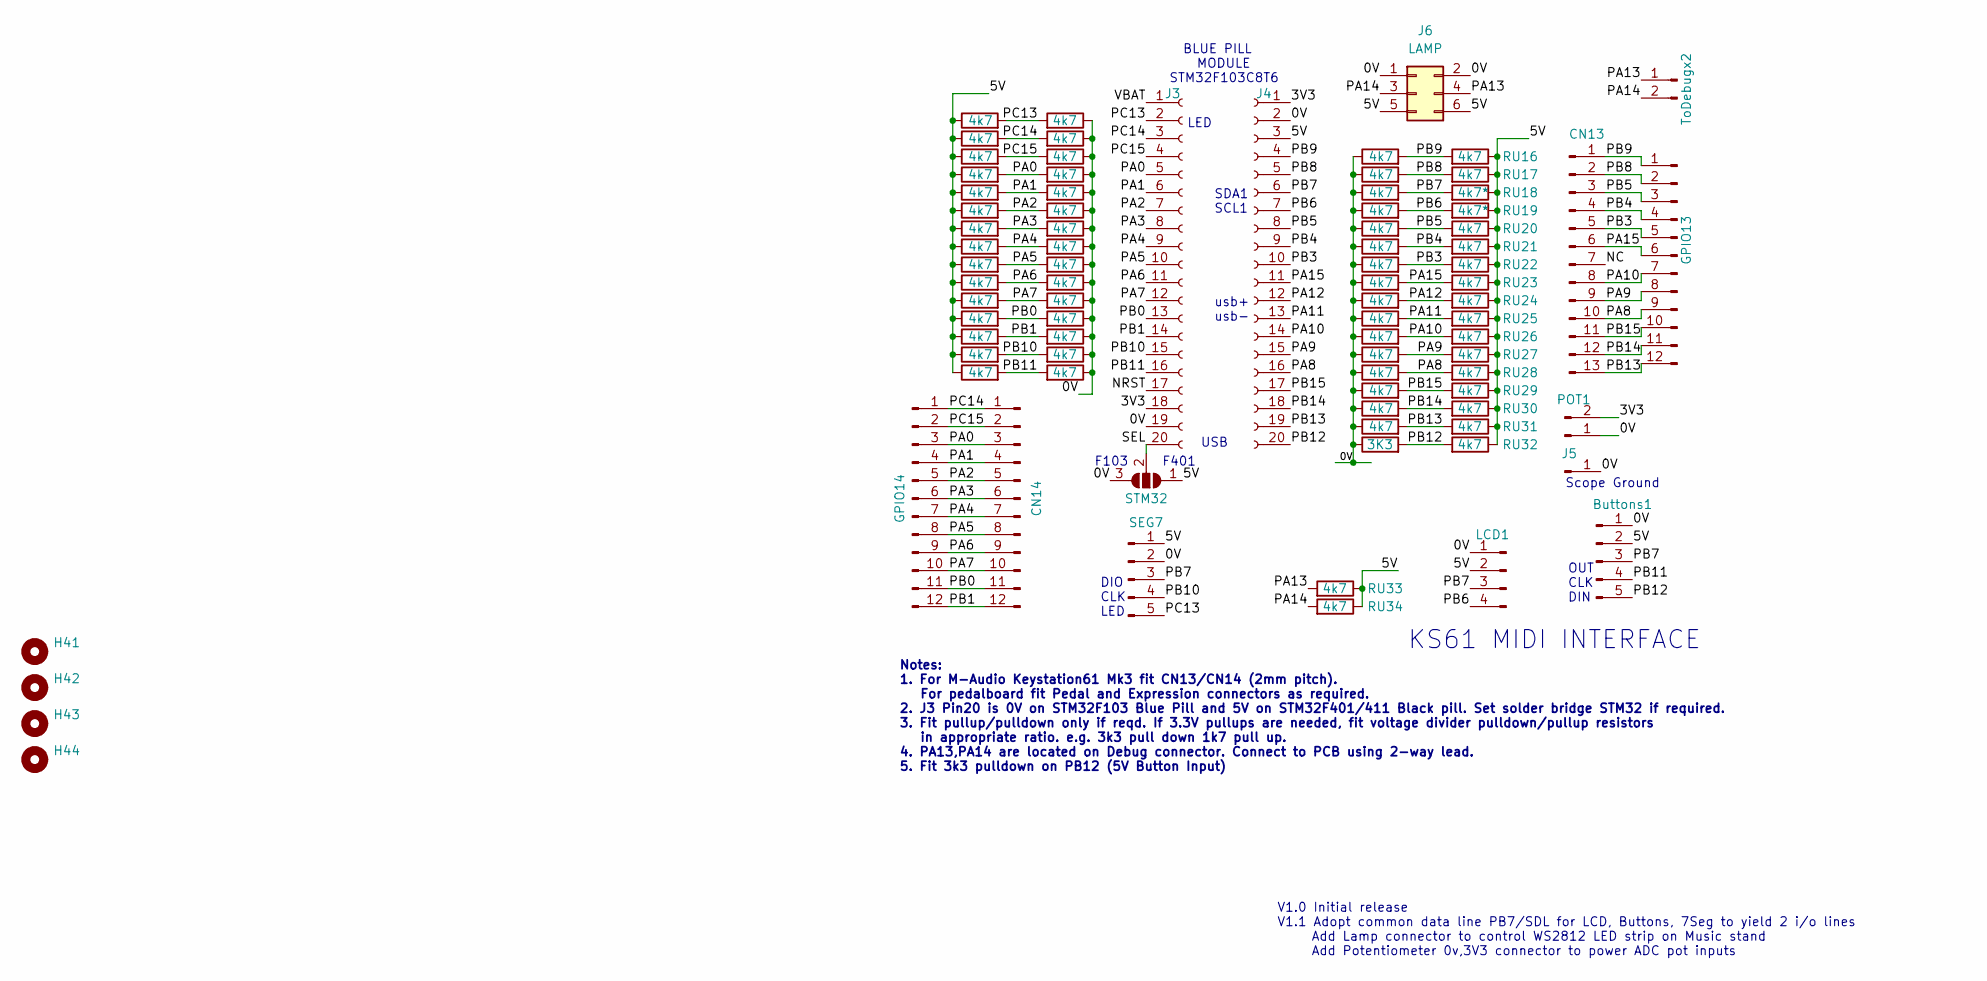
[picture p15: schematic MidiInterfaceKS61.kicad_sch]

Parts:
Buttons1: Conn_01x05_Male; PinHeader_1x05_P2.54mm_Vertical
CN13: Conn_01x13_Male; PinHeader_1x13_P2.00mm_Vertical
CN14: Conn_01x12_Male; PinHeader_1x12_P2.00mm_Vertical
GPIO13, GPIO14: Conn_01x12_Male; PinHeader_1x12_P2.54mm_Vertical
H41, H42, H43, H44: MountingHole; MountingHole_3.2mm_M3
J3, J4: Conn_01x20_Female; PinHeader_1x20_P2.54mm_Vertical
J5: Conn_01x01_Male; PinHeader_1x01_P2.54mm_Vertical
J6: LAMP; PinHeader_2x03_P2.54mm_Vertical
LCD1: Conn_01x04_Male; PinHeader_1x04_P2.54mm_Vertical
POT1: Conn_01x02_Male; PinHeader_1x02_P2.54mm_Vertical
RD1, RD2, RD3, RD4, RD5, RD6, RD7, RD8, RD9, RD10, RD11, RD12, RD13, RD14, RD15, RD16, RD17, RD18, RD19, RD20, RD21, RD22, RD23, RD24, RD25, RD26, RD27, RD28, RD29, RD30, RD31: 4k7; R_0805_2012Metric_Pad1.20x1.40mm_HandSolder
RD32: 3K3; R_0805_2012Metric_Pad1.20x1.40mm_HandSolder
RU1, RU2, RU3, RU4, RU5, RU6, RU7, RU8, RU9, RU10, RU11, RU12, RU13, RU14, RU15, RU16, RU17, RU20, RU21, RU22, RU23, RU24, RU25, RU26, RU27, RU28, RU29, RU30, RU31, RU32, RU33, RU34: 4k7; R_0805_2012Metric_Pad1.20x1.40mm_HandSolder
RU18, RU19: 4k7*; R_0805_2012Metric_Pad1.20x1.40mm_HandSolder
SEG7: Conn_01x05_Male; PinHeader_1x05_P2.54mm_Vertical
STM32: SolderJumper_3_Open; SolderJumper-3_P1.3mm_Open_RoundedPad1.0x1.5mm_NumberLabels
ToDebugx2: Conn_01x02_Male; PinHeader_1x02_P2.54mm_Vertical

Connections:
/0V: Buttons1.1, J3.19, J4.2, J5.1, J6.1, J6.2, LCD1.1, POT1.1, RD1.1, RD2.1, RD3.1, RD4.1, RD5.1, RD6.1, RD7.1, RD8.1, RD9.1, RD10.1, RD11.1, RD12.1, RD13.1, RD14.1, RD15.1, RD16.1, RD17.1, RD18.1, RD19.1, RD20.1, RD21.1, RD22.1, RD23.1, RD24.1, RD25.1, RD26.1, RD27.1, RD28.1, RD29.1, RD30.1, RD31.1, RD32.1, SEG7.2, STM32.3 (B)
/3V3: J3.18, J4.1, POT1.2
/5V: Buttons1.2, J4.3, J6.5, J6.6, LCD1.2, RU1.1, RU2.1, RU3.1, RU4.1, RU5.1, RU6.1, RU7.1, RU8.1, RU9.1, RU10.1, RU11.1, RU12.1, RU13.1, RU14.1, RU15.1, RU16.1, RU17.1, RU18.1, RU19.1, RU20.1, RU21.1, RU22.1, RU23.1, RU24.1, RU25.1, RU26.1, RU27.1, RU28.1, RU29.1, RU30.1, RU31.1, RU32.1, RU33.1, RU34.1, SEG7.1, STM32.1 (A)
/NC: CN13.7
/NRST: J3.17
/PA0: CN14.3, GPIO14.3, J3.5, RD4.2, RU4.2
/PA1: CN14.4, GPIO14.4, J3.6, RD5.2, RU5.2
/PA2: CN14.5, GPIO14.5, J3.7, RD6.2, RU6.2
/PA3: CN14.6, GPIO14.6, J3.8, RD7.2, RU7.2
/PA4: CN14.7, GPIO14.7, J3.9, RD8.2, RU8.2
/PA5: CN14.8, GPIO14.8, J3.10, RD9.2, RU9.2
/PA6: CN14.9, GPIO14.9, J3.11, RD10.2, RU10.2
/PA7: CN14.10, GPIO14.10, J3.12, RD11.2, RU11.2
/PA8: CN13.10, GPIO13.9, J4.16, RD28.2, RU28.2
/PA9: CN13.9, GPIO13.8, J4.15, RD27.2, RU27.2
/PA10: CN13.8, GPIO13.7, J4.14, RD26.2, RU26.2
/PA11: J4.13, RD25.2, RU25.2
/PA12: J4.12, RD24.2, RU24.2
/PA13: J6.4, RU33.2, ToDebugx2.1
/PA14: J6.3, RU34.2, ToDebugx2.2
/PA15: CN13.6, GPIO13.6, J4.11, RD23.2, RU23.2
/PB0: CN14.11, GPIO14.11, J3.13, RD12.2, RU12.2
/PB1: CN14.12, GPIO14.12, J3.14, RD13.2, RU13.2
/PB3: CN13.5, GPIO13.5, J4.10, RD22.2, RU22.2
/PB4: CN13.4, GPIO13.4, J4.9, RD21.2, RU21.2
/PB5: CN13.3, GPIO13.3, J4.8, RD20.2, RU20.2
/PB6: J4.7, LCD1.4, RD19.2, RU19.2
/PB7: Buttons1.3, J4.6, LCD1.3, RD18.2, RU18.2, SEG7.3
/PB8: CN13.2, GPIO13.2, J4.5, RD17.2, RU17.2
/PB9: CN13.1, GPIO13.1, J4.4, RD16.2, RU16.2
/PB10: J3.15, RD14.2, RU14.2, SEG7.4
/PB11: Buttons1.4, J3.16, RD15.2, RU15.2
/PB12: Buttons1.5, J4.20, RD32.2, RU32.2
/PB13: CN13.13, GPIO13.12, J4.19, RD31.2, RU31.2
/PB14: CN13.12, GPIO13.11, J4.18, RD30.2, RU30.2
/PB15: CN13.11, GPIO13.10, J4.17, RD29.2, RU29.2
/PC13: J3.2, RD1.2, RU1.2, SEG7.5
/PC14: CN14.1, GPIO14.1, J3.3, RD2.2, RU2.2
/PC15: CN14.2, GPIO14.2, J3.4, RD3.2, RU3.2
/SEL: J3.20, STM32.2 (C)
/VBAT: J3.1

Notes on the sheet:
BLUE PILL MODULE STM32F103C8T6
OUT CLK DIN
KS61 MIDI INTERFACE
usb+ usb-
DIO CLK LED
LED
Notes: 1. For M-Audio Keystation61 Mk3 fit CN13/CN14 (2mm pitch). For pedalboard fit Pedal and Expression connectors as required. 2. J3 Pin20 is 0V on STM32F103 Blue Pill and 5V on STM32F401/411 Black pill. Set solder bridge STM32 if required. 3. Fit pullup/pulldown only if reqd. If 3.3V pullups ar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
Scope Ground
SDA1 SCL1
V1.0 Initial release V1.1 Adopt common data line PB7/SDL for LCD, Buttons, 7Seg to yield 2 i/o lines Add Lamp connector to control WS2812 LED strip on Music stand Add Potentiometer 0v,3V3 connector to power ADC pot inputs
USB
F103 F401

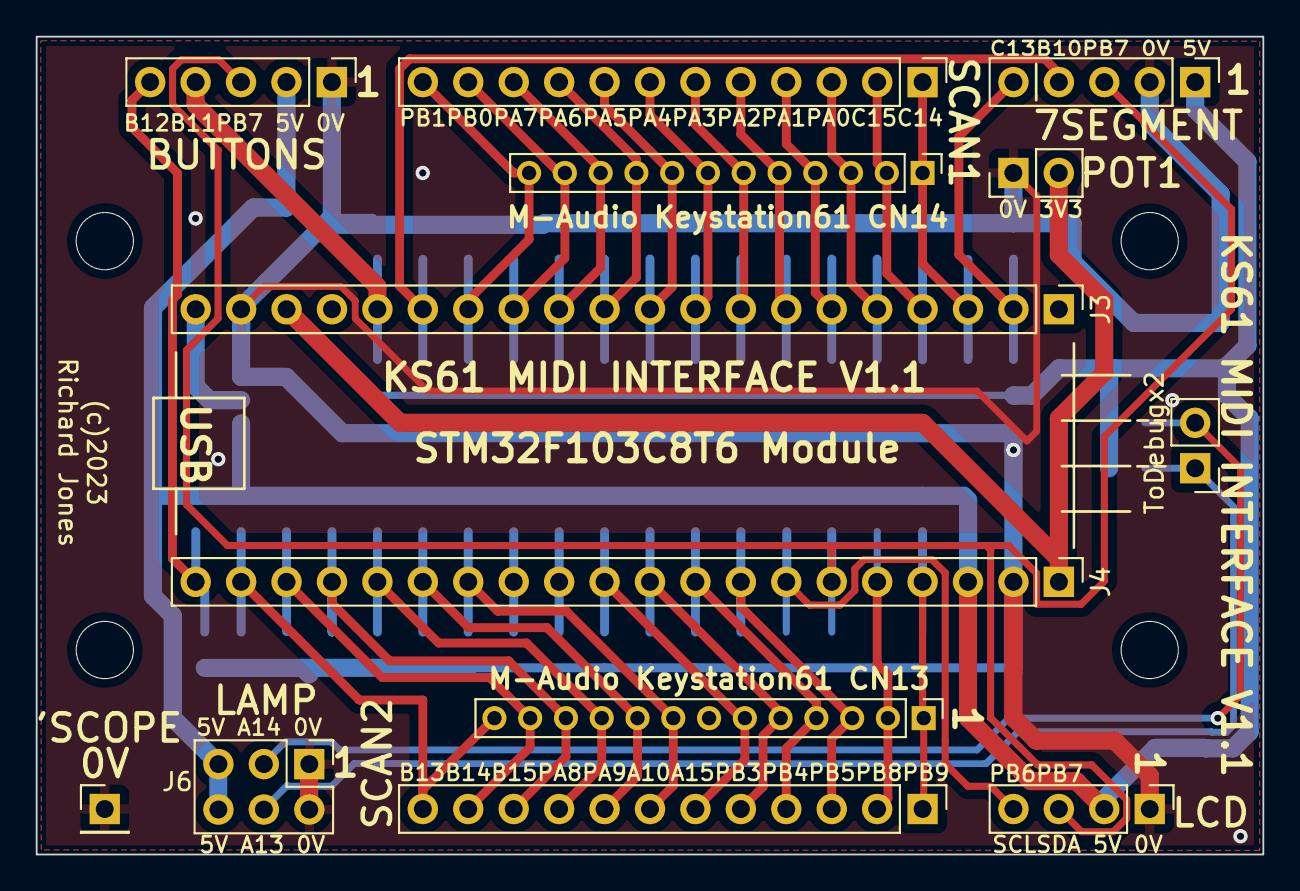
[picture p16: board MidiInterfaceKS61.kicad_pcb from above]

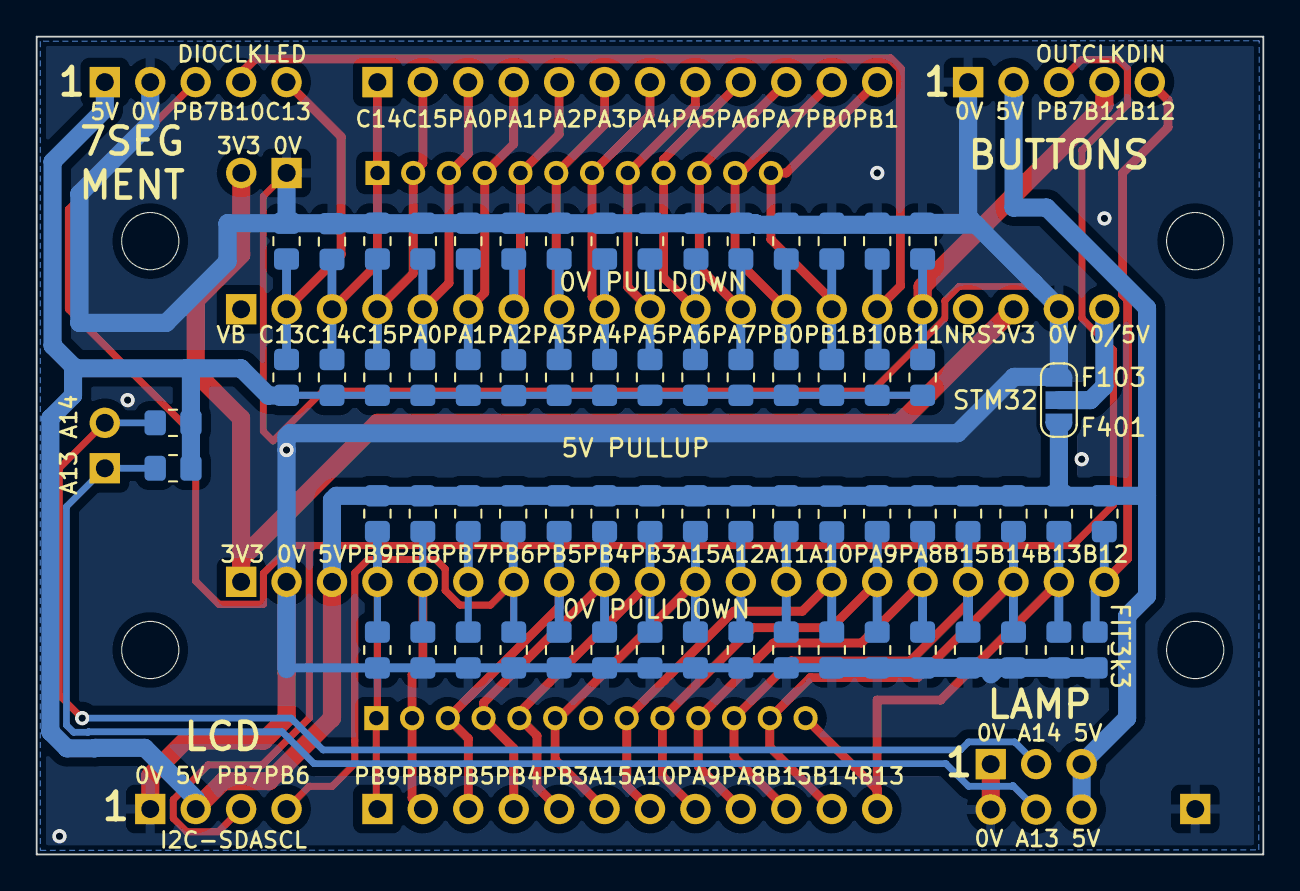
[picture p17: board MidiInterfaceKS61.kicad_pcb from below]

Board: 2 copper layers, 68.6 x 45.7 mm, 84 parts (67 on the bottom side), 38 nets.
