radionerd/VirtualPipeOrgan/PCBs/ButtonMountingBoard/ButtonMountingBoard.kicad_pcb

## KiCad design PCBs/ButtonMountingBoard/ButtonMountingBoard.kicad_pcb (2023-09-30)

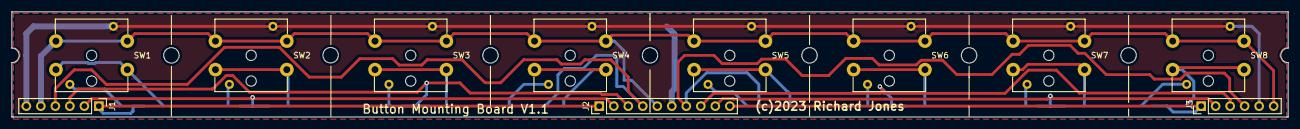
[picture p18: board ButtonMountingBoard.kicad_pcb from above]

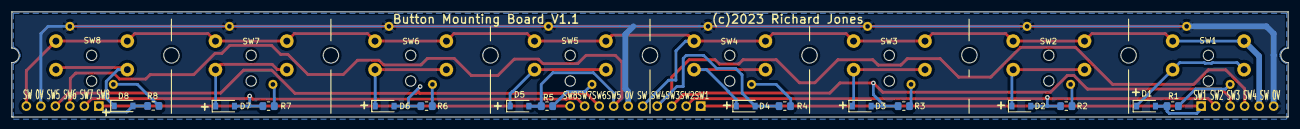
[picture p19: board ButtonMountingBoard.kicad_pcb from below]

Board: 2 copper layers, 223.5 x 18.4 mm, 34 parts (16 on the bottom side), 26 nets.

Parts:
D1, D2, D3, D4, D5, D6, D7, D8: 1N4148; D_SOD-123
H1, H2, H3, H4, H5, H6, H7: MountingHole; MountingHole_2.7mm_M2.5
J1, J3: Conn_01x06_Male; PinHeader_1x06_P2.54mm_Vertical
J2: Conn_01x10_Male; PinHeader_1x10_P2.54mm_Vertical
R1, R2, R3, R4, R5, R6, R7, R8: 560; R_0805_2012Metric_Pad1.20x1.40mm_HandSolder
SW1, SW2, SW3, SW4, SW5, SW6, SW7, SW8: SW_TACT_LED; TS12_TS27

Connections:
/LED: J1.6, J2.6, J3.5, SW1.5, SW2.5, SW3.5, SW4.5, SW5.5, SW6.5, SW7.5, SW8.5
/SW: J1.5, J2.5, J3.6, SW1.3, SW1.4, SW2.3, SW2.4, SW3.3, SW3.4, SW4.3, SW4.4, SW5.3, SW5.4, SW6.3, SW6.4, SW7.3, SW7.4, SW8.3, SW8.4
unnamed: D1.1 (K), SW1.1, SW1.2
unnamed: D1.2 (A), J1.1, J2.1, R1.2
unnamed: D2.1 (K), SW2.1, SW2.2
unnamed: D2.2 (A), J1.2, J2.2, R2.2
unnamed: D3.1 (K), SW3.1, SW3.2
unnamed: D3.2 (A), J1.3, J2.3, R3.2
unnamed: D4.1 (K), SW4.1, SW4.2
unnamed: D4.2 (A), J1.4, J2.4, R4.2
unnamed: D5.1 (K), SW5.1, SW5.2
unnamed: D5.2 (A), J2.7, J3.4, R5.2
unnamed: D6.1 (K), SW6.1, SW6.2
unnamed: D6.2 (A), J2.8, J3.3, R6.2
unnamed: D7.1 (K), SW7.1, SW7.2
unnamed: D7.2 (A), J2.9, J3.2, R7.2
unnamed: D8.1 (K), SW8.1, SW8.2
unnamed: D8.2 (A), J2.10, J3.1, R8.2
unnamed: R1.1, SW1.6
unnamed: R2.1, SW2.6
unnamed: R3.1, SW3.6
unnamed: R4.1, SW4.6
unnamed: R5.1, SW5.6
unnamed: R6.1, SW6.6
unnamed: R7.1, SW7.6
unnamed: R8.1, SW8.6
