radionerd/VirtualPipeOrgan/PCBs/WiredButtonDriver/WiredButtonDriver.kicad_pcb

## KiCad design PCBs/WiredButtonDriver/WiredButtonDriver.kicad_pcb (2023-09-30)

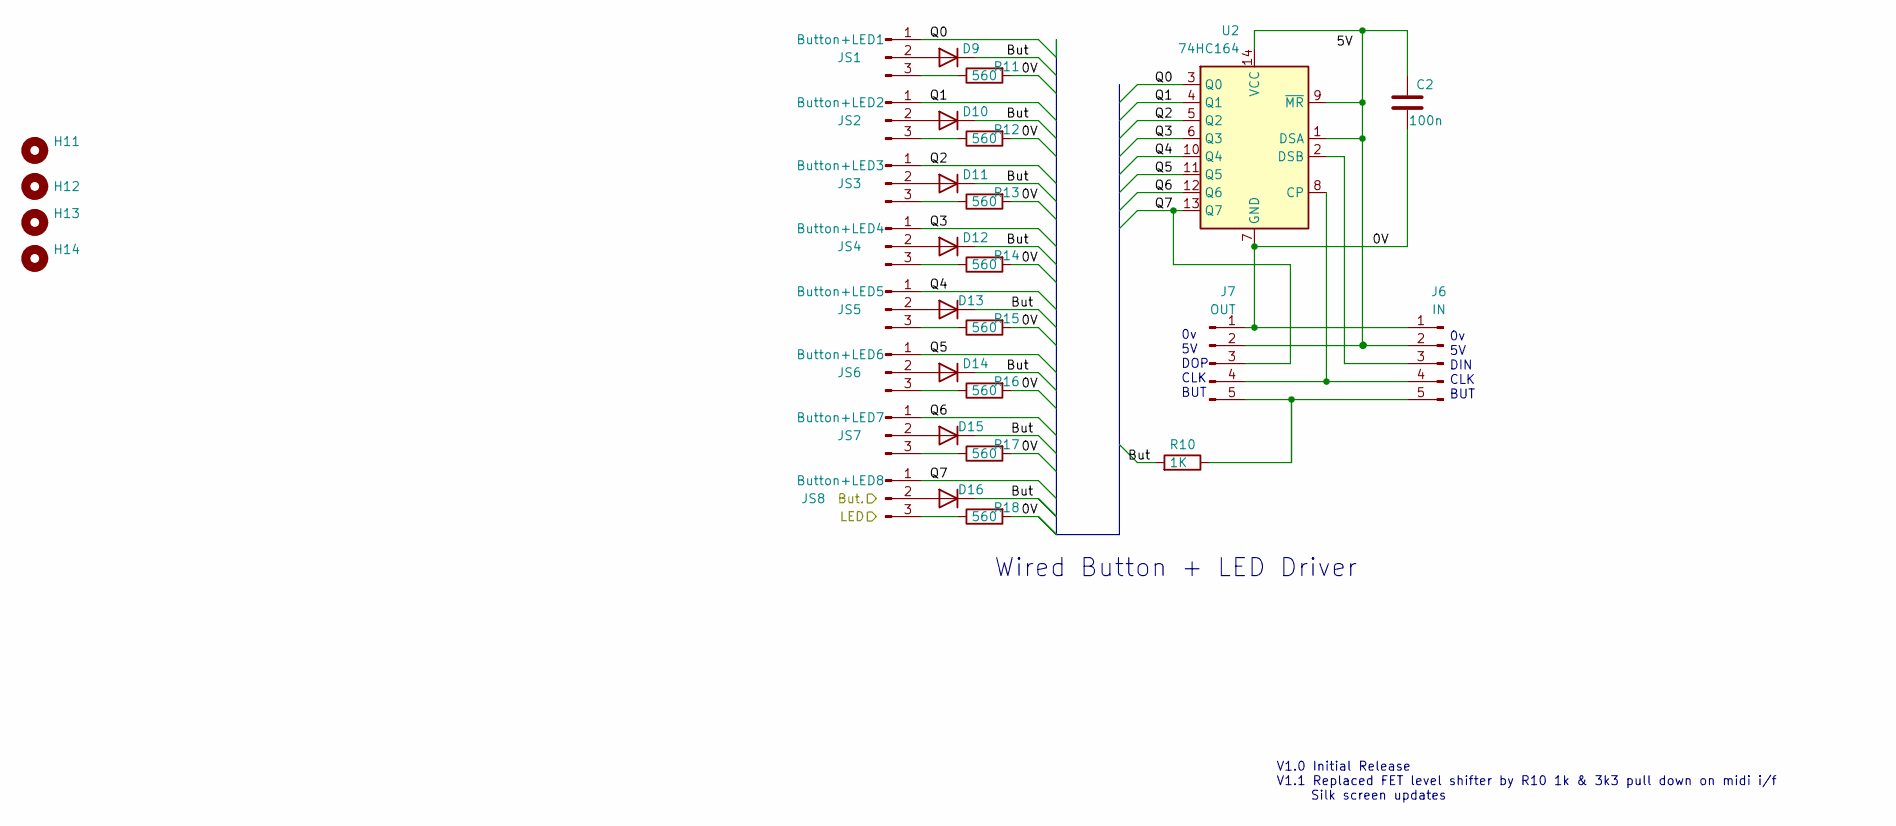
[picture p20: schematic WiredButtonDriver.kicad_sch]

Parts:
C2: 100n; C_0805_2012Metric_Pad1.18x1.45mm_HandSolder
D9, D10, D11, D12, D13, D14, D15, D16: 1N4148; D_SOD-123
H11, H12, H13, H14: MountingHole; MountingHole_3.2mm_M3
J6: IN; PinHeader_1x05_P2.54mm_Vertical
J7: OUT; PinHeader_1x05_P2.54mm_Vertical
JS1: Button+LED1; PinHeader_1x03_P2.54mm_Vertical
JS2: Button+LED2; PinHeader_1x03_P2.54mm_Vertical
JS3: Button+LED3; PinHeader_1x03_P2.54mm_Vertical
JS4: Button+LED4; PinHeader_1x03_P2.54mm_Vertical
JS5: Button+LED5; PinHeader_1x03_P2.54mm_Vertical
JS6: Button+LED6; PinHeader_1x03_P2.54mm_Vertical
JS7: Button+LED7; PinHeader_1x03_P2.54mm_Vertical
JS8: Button+LED8; PinHeader_1x03_P2.54mm_Vertical
R10: 1K; R_0805_2012Metric_Pad1.20x1.40mm_HandSolder
R11, R12, R13, R14, R15, R16, R17, R18: 560; R_0805_2012Metric_Pad1.20x1.40mm_HandSolder
U2: 74HC164; DIP-14_W7.62mm_LongPads

Connections:
/0V: C2.2, J6.1, J7.1, R11.2, R12.2, R13.2, R14.2, R15.2, R16.2, R17.2, R18.2, U2.7 (GND)
/But: D9.1 (K), D10.1 (K), D11.1 (K), D12.1 (K), D13.1 (K), D14.1 (K), D15.1 (K), D16.1 (K), R10.2
/Q0: JS1.1, U2.3 (Q0)
/Q1: JS2.1, U2.4 (Q1)
/Q2: JS3.1, U2.5 (Q2)
/Q3: JS4.1, U2.6 (Q3)
/Q4: JS5.1, U2.10 (Q4)
/Q5: JS6.1, U2.11 (Q5)
/Q6: JS7.1, U2.12 (Q6)
/Q7: J7.3, JS8.1, U2.13 (Q7)
unnamed: C2.1, J6.2, J7.2, U2.1 (DSA), U2.9 (~MR), U2.14 (VCC)
unnamed: D9.2 (A), JS1.2
unnamed: D10.2 (A), JS2.2
unnamed: D11.2 (A), JS3.2
unnamed: D12.2 (A), JS4.2
unnamed: D13.2 (A), JS5.2
unnamed: D14.2 (A), JS6.2
unnamed: D15.2 (A), JS7.2
unnamed: D16.2 (A), JS8.2
unnamed: J6.3, U2.2 (DSB)
unnamed: J6.4, J7.4, U2.8 (CP)
unnamed: J6.5, J7.5, R10.1
unnamed: JS1.3, R11.1
unnamed: JS2.3, R12.1
unnamed: JS3.3, R13.1
unnamed: JS4.3, R14.1
unnamed: JS5.3, R15.1
unnamed: JS6.3, R16.1
unnamed: JS7.3, R17.1
unnamed: JS8.3, R18.1

Notes on the sheet:
0v 5V DOP CLK BUT
0v 5V DIN CLK BUT
V1.0 Initial Release V1.1 Replaced FET level shifter by R10 1k & 3k3 pull down on midi i/f Silk screen updates
Wired Button + LED Driver

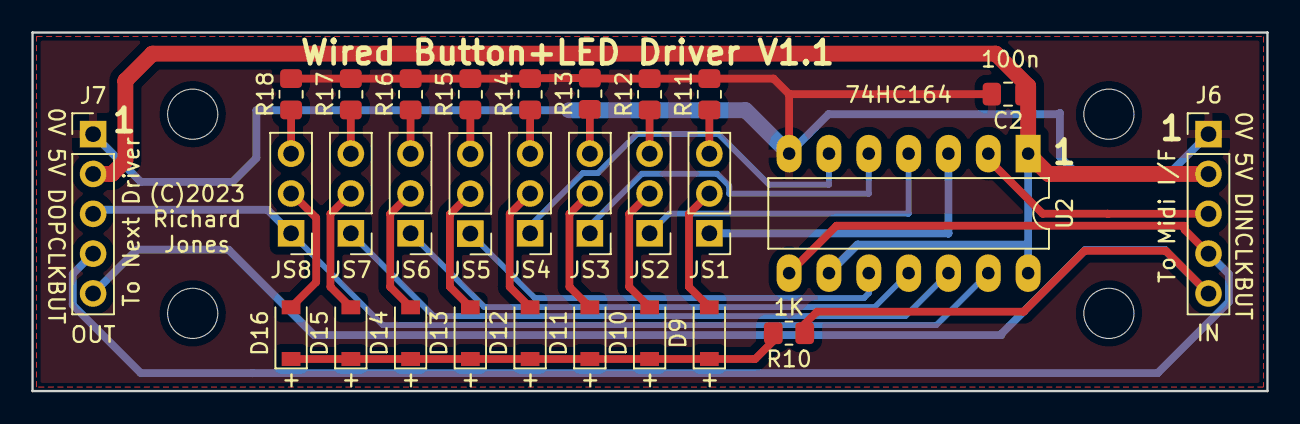
[picture p21: board WiredButtonDriver.kicad_pcb from above]

Board: 2 copper layers, 78.7 x 22.9 mm, 33 parts (0 on the bottom side), 30 nets.
