radionerd/VirtualPipeOrgan/PCBs/CombinedKS61Prototype/CombinedKS61Prototype.kicad_pcb

## KiCad design PCBs/CombinedKS61Prototype/CombinedKS61Prototype.kicad_pcb (2023-09-30)

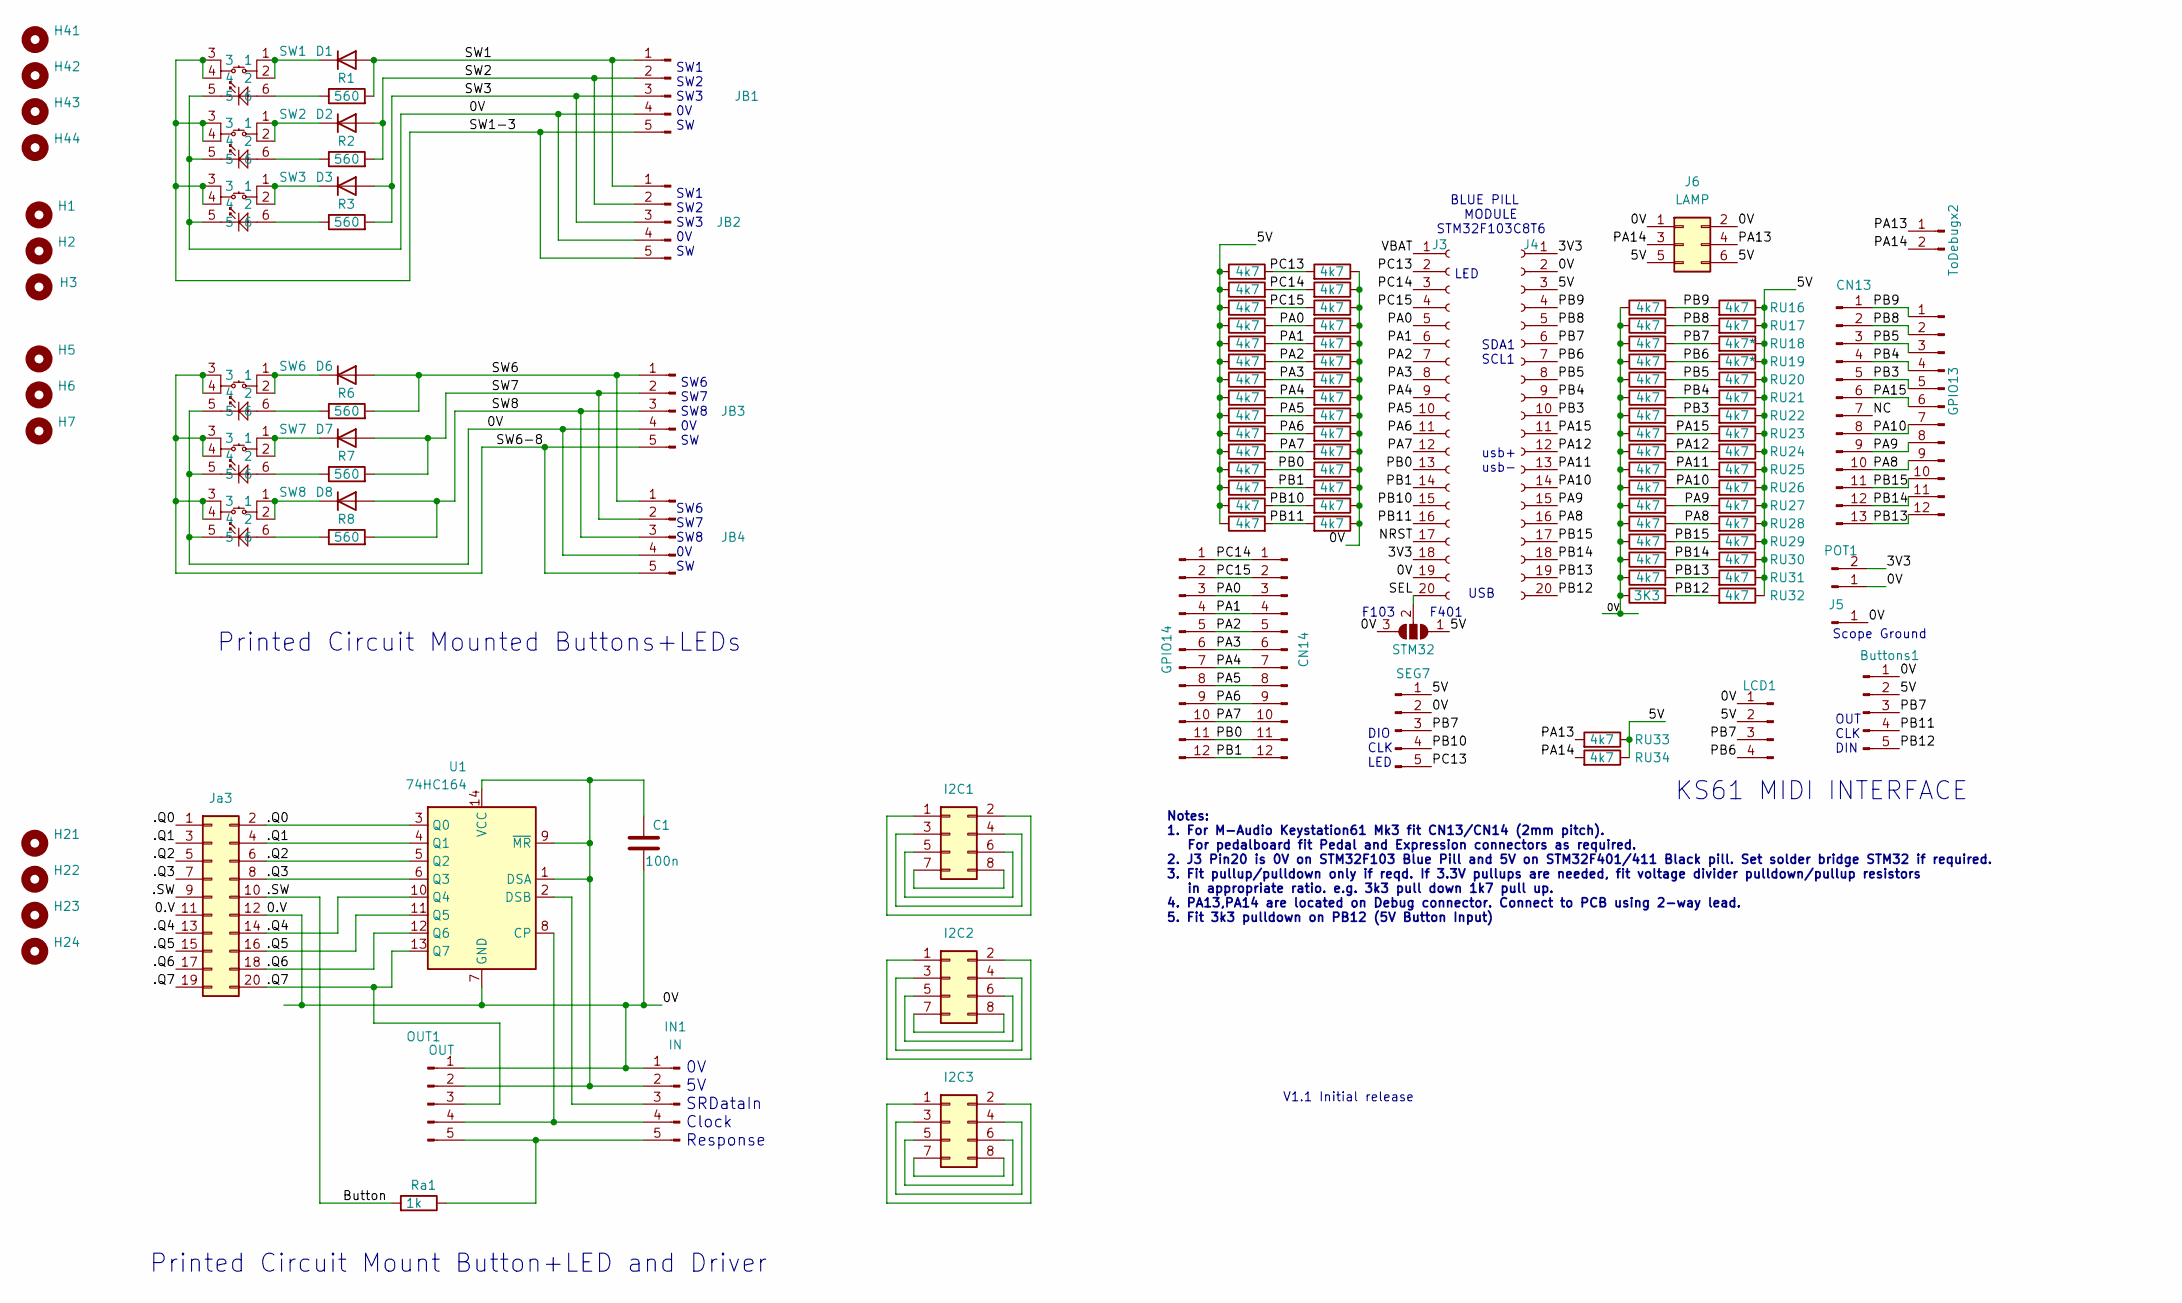
[picture p22: schematic CombinedKS61Prototype.kicad_sch]

Parts:
Buttons1: Conn_01x05_Male; PinHeader_1x05_P2.54mm_Vertical
C1: 100n; C_0805_2012Metric_Pad1.18x1.45mm_HandSolder
CN13: Conn_01x13_Male; PinHeader_1x13_P2.00mm_Vertical
CN14: Conn_01x12_Male; PinHeader_1x12_P2.00mm_Vertical
D1, D2, D3, D6, D7, D8: 1N4148; D_SOD-123
GPIO13, GPIO14: Conn_01x12_Male; PinHeader_1x12_P2.54mm_Vertical
H1, H2, H3, H5, H6, H7: MountingHole; MountingHole_2.7mm_M2.5
H21, H22, H23, H24, H41, H42, H43, H44: MountingHole; MountingHole_3.2mm_M3
I2C1, I2C2, I2C3: Conn_02x04_Odd_Even; PinHeader_2x04_P2.54mm_Vertical
IN1: IN; PinHeader_1x05_P2.54mm_Vertical
J3, J4: Conn_01x20_Female; PinHeader_1x20_P2.54mm_Vertical
J5: Conn_01x01_Male; PinHeader_1x01_P2.54mm_Vertical
J6: LAMP; PinHeader_2x03_P2.54mm_Vertical
JB1, JB2, JB3, JB4: Conn_01x05_Male; PinHeader_1x05_P2.54mm_Vertical
Ja3: Conn_02x10_Odd_Even; PinHeader_2x10_P2.54mm_Vertical
LCD1: Conn_01x04_Male; PinHeader_1x04_P2.54mm_Vertical
OUT1: OUT; PinHeader_1x05_P2.54mm_Vertical
POT1: Conn_01x02_Male; PinHeader_1x02_P2.54mm_Vertical
R1, R2, R3, R6, R7, R8: 560; R_0805_2012Metric_Pad1.20x1.40mm_HandSolder
RD1, RD2, RD3, RD4, RD5, RD6, RD7, RD8, RD9, RD10, RD11, RD12, RD13, RD14, RD15, RD16, RD17, RD18, RD19, RD20, RD21, RD22, RD23, RD24, RD25, RD26, RD27, RD28, RD29, RD30, RD31: 4k7; R_0805_2012Metric_Pad1.20x1.40mm_HandSolder
RD32: 3K3; R_0805_2012Metric_Pad1.20x1.40mm_HandSolder
RU1, RU2, RU3, RU4, RU5, RU6, RU7, RU8, RU9, RU10, RU11, RU12, RU13, RU14, RU15, RU16, RU17, RU20, RU21, RU22, RU23, RU24, RU25, RU26, RU27, RU28, RU29, RU30, RU31, RU32, RU33, RU34: 4k7; R_0805_2012Metric_Pad1.20x1.40mm_HandSolder
RU18, RU19: 4k7*; R_0805_2012Metric_Pad1.20x1.40mm_HandSolder
Ra1: 1k; R_0805_2012Metric_Pad1.20x1.40mm_HandSolder
SEG7: Conn_01x05_Male; PinHeader_1x05_P2.54mm_Vertical
STM32: SolderJumper_3_Open; SolderJumper-3_P1.3mm_Open_RoundedPad1.0x1.5mm_NumberLabels
SW1, SW2, SW3, SW6, SW7, SW8: SW_TACT_LED; TS12_TS27
ToDebugx2: Conn_01x02_Male; PinHeader_1x02_P2.54mm_Vertical
U1: 74HC164; DIP-14_W7.62mm_LongPads

Connections:
/0.V: Buttons1.1, C1.2, IN1.1, J3.19, J4.2, J5.1, J6.1, J6.2, JB1.4, JB2.4, JB3.4, JB4.4, Ja3.11, Ja3.12, LCD1.1, OUT1.1, POT1.1, RD1.1, RD2.1, RD3.1, RD4.1, RD5.1, RD6.1, RD7.1, RD8.1, RD9.1, RD10.1, RD11.1, RD12.1, RD13.1, RD14.1, RD15.1, RD16.1, RD17.1, RD18.1, RD19.1, RD20.1, RD21.1, RD22.1, RD23.1, RD24.1, RD25.1, RD26.1, RD27.1, RD28.1, RD29.1, RD30.1, RD31.1, RD32.1, SEG7.2, STM32.3 (B), SW1.5, SW2.5, SW3.5, SW6.5, SW7.5, SW8.5, U1.7 (GND)
/3V3: J3.18, J4.1, POT1.2
/5V: Buttons1.2, J4.3, J6.5, J6.6, LCD1.2, RU1.1, RU2.1, RU3.1, RU4.1, RU5.1, RU6.1, RU7.1, RU8.1, RU9.1, RU10.1, RU11.1, RU12.1, RU13.1, RU14.1, RU15.1, RU16.1, RU17.1, RU18.1, RU19.1, RU20.1, RU21.1, RU22.1, RU23.1, RU24.1, RU25.1, RU26.1, RU27.1, RU28.1, RU29.1, RU30.1, RU31.1, RU32.1, RU33.1, RU34.1, SEG7.1, STM32.1 (A)
/.Q0: Ja3.1, Ja3.2, U1.3 (Q0)
/.Q1: Ja3.3, Ja3.4, U1.4 (Q1)
/.Q2: Ja3.5, Ja3.6, U1.5 (Q2)
/.Q3: Ja3.7, Ja3.8, U1.6 (Q3)
/.Q4: Ja3.13, Ja3.14, U1.10 (Q4)
/.Q5: Ja3.15, Ja3.16, U1.11 (Q5)
/.Q6: Ja3.17, Ja3.18, U1.12 (Q6)
/.Q7: Ja3.19, Ja3.20, OUT1.3, U1.13 (Q7)
/.SW: Ja3.9, Ja3.10, Ra1.2
/NC: CN13.7
/NRST: J3.17
/PA0: CN14.3, GPIO14.3, J3.5, RD4.2, RU4.2
/PA1: CN14.4, GPIO14.4, J3.6, RD5.2, RU5.2
/PA2: CN14.5, GPIO14.5, J3.7, RD6.2, RU6.2
/PA3: CN14.6, GPIO14.6, J3.8, RD7.2, RU7.2
/PA4: CN14.7, GPIO14.7, J3.9, RD8.2, RU8.2
/PA5: CN14.8, GPIO14.8, J3.10, RD9.2, RU9.2
/PA6: CN14.9, GPIO14.9, J3.11, RD10.2, RU10.2
/PA7: CN14.10, GPIO14.10, J3.12, RD11.2, RU11.2
/PA8: CN13.10, GPIO13.9, J4.16, RD28.2, RU28.2
/PA9: CN13.9, GPIO13.8, J4.15, RD27.2, RU27.2
/PA10: CN13.8, GPIO13.7, J4.14, RD26.2, RU26.2
/PA11: J4.13, RD25.2, RU25.2
/PA12: J4.12, RD24.2, RU24.2
/PA13: J6.4, RU33.2, ToDebugx2.1
/PA14: J6.3, RU34.2, ToDebugx2.2
/PA15: CN13.6, GPIO13.6, J4.11, RD23.2, RU23.2
/PB0: CN14.11, GPIO14.11, J3.13, RD12.2, RU12.2
/PB1: CN14.12, GPIO14.12, J3.14, RD13.2, RU13.2
/PB3: CN13.5, GPIO13.5, J4.10, RD22.2, RU22.2
/PB4: CN13.4, GPIO13.4, J4.9, RD21.2, RU21.2
/PB5: CN13.3, GPIO13.3, J4.8, RD20.2, RU20.2
/PB6: J4.7, LCD1.4, RD19.2, RU19.2
/PB7: Buttons1.3, J4.6, LCD1.3, RD18.2, RU18.2, SEG7.3
/PB8: CN13.2, GPIO13.2, J4.5, RD17.2, RU17.2
/PB9: CN13.1, GPIO13.1, J4.4, RD16.2, RU16.2
/PB10: J3.15, RD14.2, RU14.2, SEG7.4
/PB11: Buttons1.4, J3.16, RD15.2, RU15.2
/PB12: Buttons1.5, J4.20, RD32.2, RU32.2
/PB13: CN13.13, GPIO13.12, J4.19, RD31.2, RU31.2
/PB14: CN13.12, GPIO13.11, J4.18, RD30.2, RU30.2
/PB15: CN13.11, GPIO13.10, J4.17, RD29.2, RU29.2
/PC13: J3.2, RD1.2, RU1.2, SEG7.5
/PC14: CN14.1, GPIO14.1, J3.3, RD2.2, RU2.2
/PC15: CN14.2, GPIO14.2, J3.4, RD3.2, RU3.2
/SEL: J3.20, STM32.2 (C)
/SW1: D1.2 (A), JB1.1, JB2.1, R1.2
/SW1-3: JB1.5, JB2.5, SW1.3, SW1.4, SW2.3, SW2.4, SW3.3, SW3.4
/SW2: D2.2 (A), JB1.2, JB2.2, R2.2
/SW3: D3.2 (A), JB1.3, JB2.3, R3.2
/SW6: D6.2 (A), JB3.1, JB4.1, R6.2
/SW6-8: JB3.5, JB4.5, SW6.3, SW6.4, SW7.3, SW7.4, SW8.3, SW8.4
/SW7: D7.2 (A), JB3.2, JB4.2, R7.2
/SW8: D8.2 (A), JB3.3, JB4.3, R8.2
/VBAT: J3.1
unnamed: C1.1, IN1.2, OUT1.2, U1.1 (DSA), U1.9 (~MR), U1.14 (VCC)
unnamed: D1.1 (K), SW1.1, SW1.2
unnamed: D2.1 (K), SW2.1, SW2.2
unnamed: D3.1 (K), SW3.1, SW3.2
unnamed: D6.1 (K), SW6.1, SW6.2
unnamed: D7.1 (K), SW7.1, SW7.2
unnamed: D8.1 (K), SW8.1, SW8.2
unnamed: I2C1.1, I2C1.2
unnamed: I2C1.3, I2C1.4
unnamed: I2C1.5, I2C1.6
unnamed: I2C1.7, I2C1.8
unnamed: I2C2.1, I2C2.2
unnamed: I2C2.3, I2C2.4
unnamed: I2C2.5, I2C2.6
unnamed: I2C2.7, I2C2.8
unnamed: I2C3.1, I2C3.2
unnamed: I2C3.3, I2C3.4
unnamed: I2C3.5, I2C3.6
unnamed: I2C3.7, I2C3.8
unnamed: IN1.3, U1.2 (DSB)
unnamed: IN1.4, OUT1.4, U1.8 (CP)
unnamed: IN1.5, OUT1.5, Ra1.1
unnamed: R1.1, SW1.6
unnamed: R2.1, SW2.6
unnamed: R3.1, SW3.6
unnamed: R6.1, SW6.6
unnamed: R7.1, SW7.6
unnamed: R8.1, SW8.6

Notes on the sheet:
Printed Circuit Mount Button+LED and Driver
BLUE PILL MODULE STM32F103C8T6
Scope Ground
usb+ usb-
V1.1 Initial release
OUT CLK DIN
Printed Circuit Mounted Buttons+LEDs
SW1 SW2 SW3 0V SW
SDA1 SCL1
USB
Notes: 1. For M-Audio Keystation61 Mk3 fit CN13/CN14 (2mm pitch). For pedalboard fit Pedal and Expression connectors as required. 2. J3 Pin20 is 0V on STM32F103 Blue Pill and 5V on STM32F401/411 Black pill. Set solder bridge STM32 if required. 3. Fit pullup/pulldown only if reqd. If 3.3V pullups ar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
0V 5V SRDataIn Clock Response
DIO CLK LED
KS61 MIDI INTERFACE
LED
SW6 SW7 SW8 0V SW
F103 F401
