radionerd/VirtualPipeOrgan/PCBs/CombinedKS61Prototype/CombinedKS61Prototype.kicad_pcb

## KiCad design PCBs/CombinedKS61Prototype/CombinedKS61Prototype.kicad_pcb (continued)

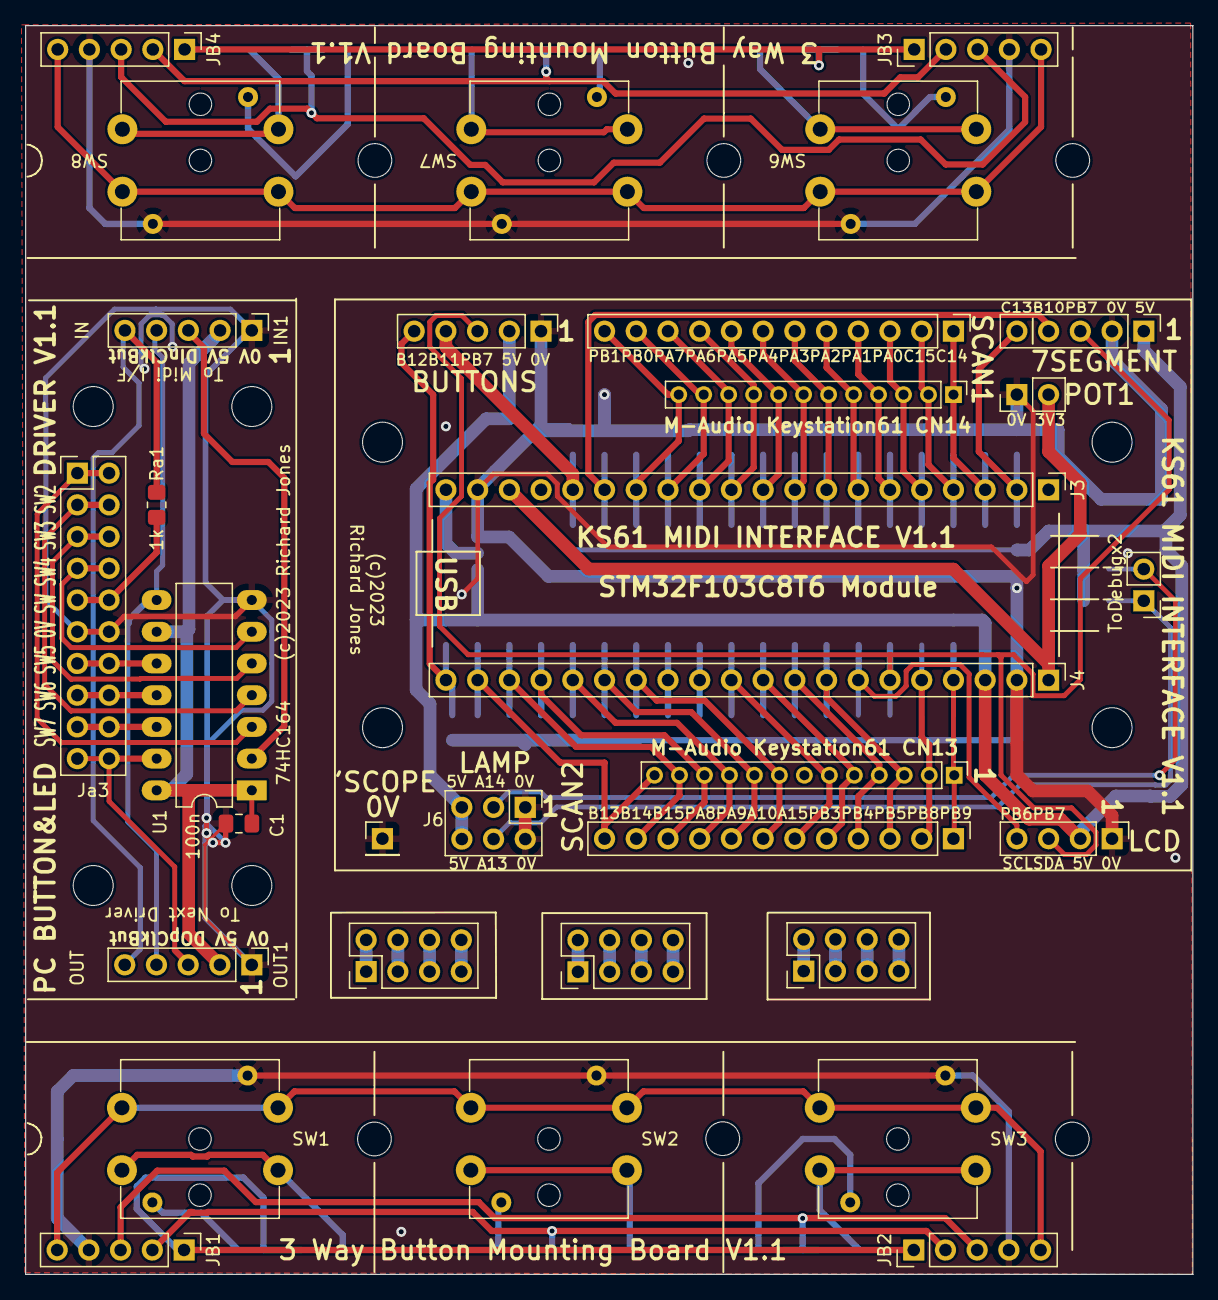
[picture p23: board CombinedKS61Prototype.kicad_pcb from above]

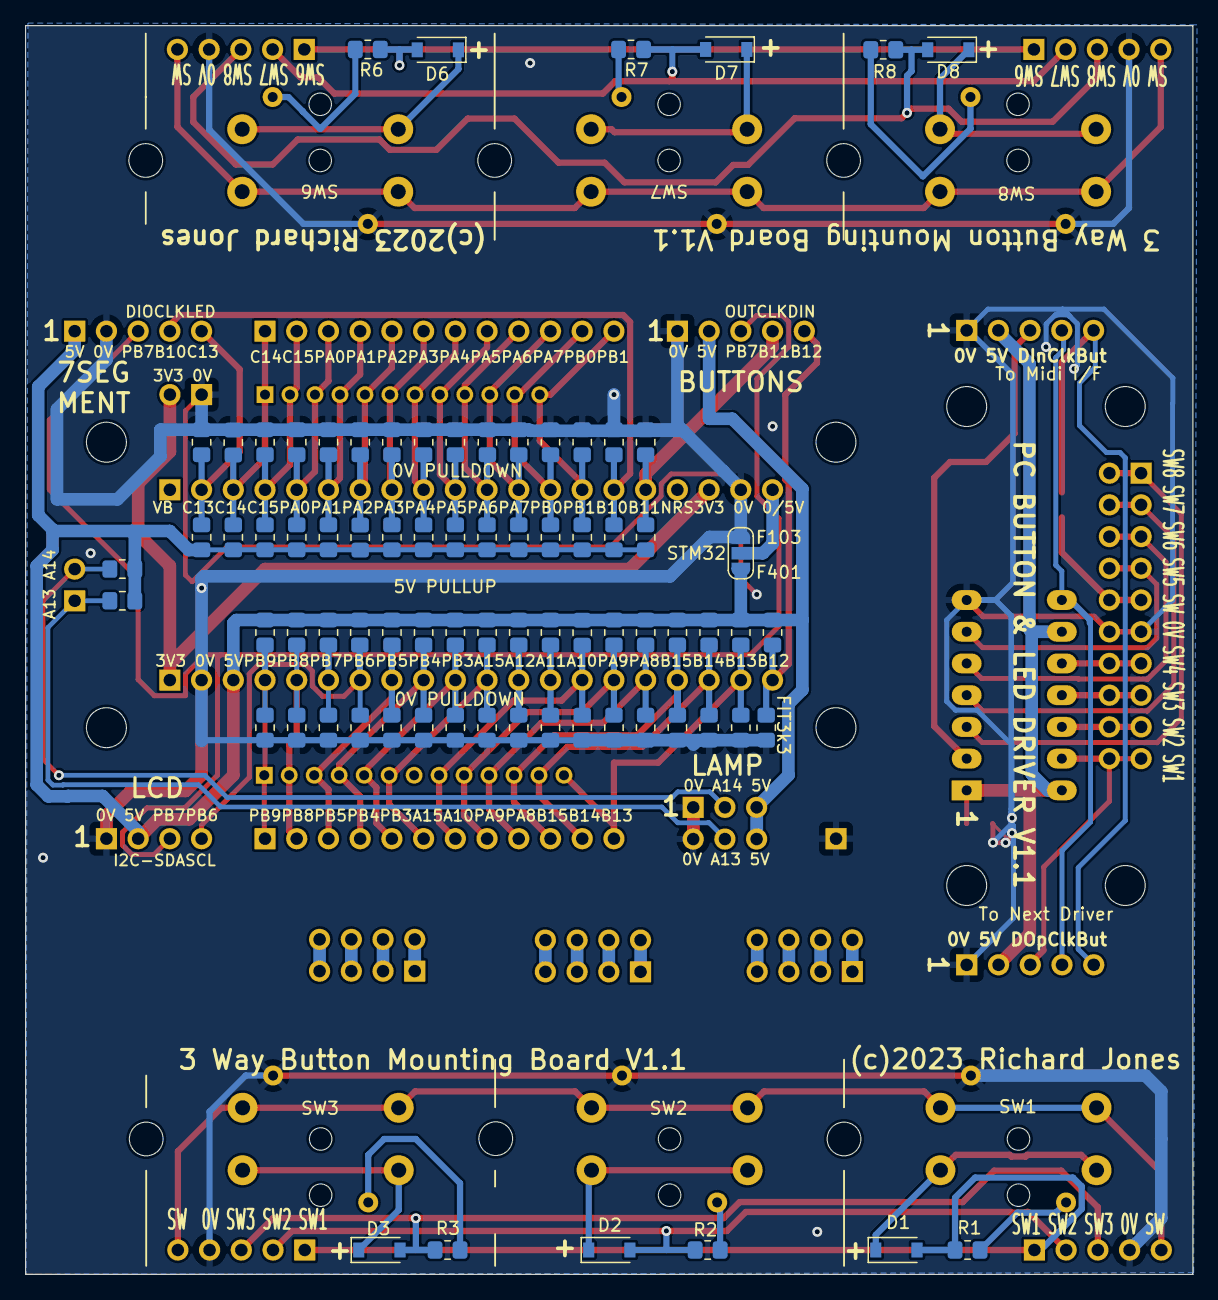
[picture p24: board CombinedKS61Prototype.kicad_pcb from below]

Board: 2 copper layers, 93.5 x 100.0 mm, 125 parts (79 on the bottom side), 83 nets.
