radionerd/VirtualPipeOrgan/MidiFirmware/bluepill_ws2812.h

#ifndef bluepill_ws2812_h
#define bluepill_ws2812_h

#include "Arduino.h"

// https://github.com/FearlessNight/bluepill_ws2812/blob/master/bluepill_ws2812.cpp

// STM32F103C8 registers
typedef struct
{ volatile uint32_t DHCSR;                   /*!< Offset: 0x000 (R/W)  Debug Halting Control and Status Register    */
  volatile uint32_t DCRSR;                   /*!< Offset: 0x004 ( /W)  Debug Core Register Selector Register        */
  volatile uint32_t DCRDR;                   /*!< Offset: 0x008 (R/W)  Debug Core Register Data Register            */
  volatile uint32_t DEMCR;                   /*!< Offset: 0x00C (R/W)  Debug Exception and Monitor Control Register */
} CoreDebug_Type;
#define CoreDebug_BASE      (0xE000EDF0UL)                            /*!< Core Debug Base Address            */
#define CoreDebug           ((CoreDebug_Type *)     CoreDebug_BASE)   /*!< Core Debug configuration struct    */
#define CoreDebug_DEMCR_TRCENA_Pos         24                                             /*!< CoreDebug DEMCR: TRCENA Position */
#define CoreDebug_DEMCR_TRCENA_Msk         (1UL << CoreDebug_DEMCR_TRCENA_Pos)            /*!< CoreDebug DEMCR: TRCENA Mask */
typedef struct
{ volatile uint32_t CTRL;                    /*!< Offset: 0x000 (R/W)  Control Register                          */
  volatile uint32_t CYCCNT;                  /*!< Offset: 0x004 (R/W)  Cycle Count Register                      */
  volatile uint32_t CPICNT;                  /*!< Offset: 0x008 (R/W)  CPI Count Register                        */
  volatile uint32_t EXCCNT;                  /*!< Offset: 0x00C (R/W)  Exception Overhead Count Register         */
  volatile uint32_t SLEEPCNT;                /*!< Offset: 0x010 (R/W)  Sleep Count Register                      */
  volatile uint32_t LSUCNT;                  /*!< Offset: 0x014 (R/W)  LSU Count Register                        */
  volatile uint32_t FOLDCNT;                 /*!< Offset: 0x018 (R/W)  Folded-instruction Count Register         */
  volatile uint32_t PCSR;                    /*!< Offset: 0x01C (R/ )  Program Counter Sample Register           */
  volatile uint32_t COMP0;                   /*!< Offset: 0x020 (R/W)  Comparator Register 0                     */
  volatile uint32_t MASK0;                   /*!< Offset: 0x024 (R/W)  Mask Register 0                           */
  volatile uint32_t FUNCTION0;               /*!< Offset: 0x028 (R/W)  Function Register 0                       */
            uint32_t RESERVED0[1];
  volatile uint32_t COMP1;                   /*!< Offset: 0x030 (R/W)  Comparator Register 1                     */
  volatile uint32_t MASK1;                   /*!< Offset: 0x034 (R/W)  Mask Register 1                           */
  volatile uint32_t FUNCTION1;               /*!< Offset: 0x038 (R/W)  Function Register 1                       */
            uint32_t RESERVED1[1];
  volatile uint32_t COMP2;                   /*!< Offset: 0x040 (R/W)  Comparator Register 2                     */
  volatile uint32_t MASK2;                   /*!< Offset: 0x044 (R/W)  Mask Register 2                           */
  volatile uint32_t FUNCTION2;               /*!< Offset: 0x048 (R/W)  Function Register 2                       */
            uint32_t RESERVED2[1];
  volatile uint32_t COMP3;                   /*!< Offset: 0x050 (R/W)  Comparator Register 3                     */
  volatile uint32_t MASK3;                   /*!< Offset: 0x054 (R/W)  Mask Register 3                           */
  volatile uint32_t FUNCTION3;               /*!< Offset: 0x058 (R/W)  Function Register 3                       */
} DWT_Type;
#define DWT_BASE            (0xE0001000UL)                            /*!< DWT Base Address                   */
#define DWT                 ((DWT_Type       *)     DWT_BASE      )   /*!< DWT configuration struct           */
#define DWT_CTRL_CYCCNTENA_Pos              0                                          /*!< DWT CTRL: CYCCNTENA Position */
#define DWT_CTRL_CYCCNTENA_Msk             (0x1UL << DWT_CTRL_CYCCNTENA_Pos)           /*!< DWT CTRL: CYCCNTENA Mask */
#define GPIOA_ADDR 0x40010800
#define GPIOB_ADDR 0x40010C00
#define GPIOC_ADDR 0x40011000
// stm32 macros
#define cli() nvic_globalirq_disable()
#define sei() nvic_globalirq_enable()

// WS2812 timing
const unsigned int CLOCK_FREQUENCY_MHZ = 72;
#define   C_NS(_NS) (_NS*CLOCK_FREQUENCY_MHZ/1000)
#define T0H C_NS(400)
#define T1H C_NS(800)
#define THL C_NS(1250)

// pixel data buffer structure
union pixel 
{ struct { uint8_t g; uint8_t r; uint8_t b; } rgb;
//  struct { uint8_t g; uint8_t r; uint8_t b; } grb;
  uint8_t bytes[3];
};

class bluepill_neopixel
{
  public:
    void begin( uint32_t port_addr, uint8_t port_bit );
    void paint( uint8_t *pixels, uint16_t count, uint32_t port_addr, uint8_t port_bit );
};

#endif
