radionerd/VirtualPipeOrgan/MidiFirmware/hsvtorgb.c

#include <math.h>

typedef struct RGBColor {
	int r;
	int g;
	int b;
} RGBColor;

RGBColor hsv2rgb(float H, float S, float V) {
	float r, g, b;
	
	//float h = H / 360;
	//float s = S / 100;
	//float v = V / 100;
	float h = H / 255;
	float s = S / 255;
	float v = V / 255;
	
	int i = floor(h * 6);
	float f = h * 6 - i;
	float p = v * (1 - s);
	float q = v * (1 - f * s);
	float t = v * (1 - (1 - f) * s);
	
	switch (i % 6) {
		case 0: r = v, g = t, b = p; break;
		case 1: r = q, g = v, b = p; break;
		case 2: r = p, g = v, b = t; break;
		case 3: r = p, g = q, b = v; break;
		case 4: r = t, g = p, b = v; break;
		default: r = v, g = p, b = q; break; // default avoids compiler warning on case 5:
	}
	
	RGBColor color;
	color.r = r * 255;
	color.g = g * 255;
	color.b = b * 255;
	
	return color;
}
