radionerd/VirtualPipeOrgan/(commit log)

2023-08-24 Added round spacer washers to bracket
2023-08-24 Added generated dxf output files
    [musicStand.dxf, test.dxf, tray172.dxf, tray308.dxf, tray444.dxf]
2023-09-04 V1.0 PCB designs
    [ButtonMountingBoard.kicad_pcb, ButtonMountingBoard.kicad_sch, MidiInterface.kicad_pcb, MidiInterface.kicad_sch, MidiInterfaceKS61.kicad_pcb, MidiInterfaceKS61.kicad_sch, MidiInterfacePedalBoard.kicad_pcb, MidiInterfacePedalBoard.kicad_sch]
2023-09-29 Console Drawings update following test cut, main cutting and assembly: 1 Reduce button cutout 17mm -> 14.5mm square 2 Rename trays trayI, trayII, trayIII 3 Add 9mm to trayII, 18mm to trayI 4 Add 4 fi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
    [tray172.dxf, tray308.dxf, trayI.dxf, trayII.dxf, trayIII.dxf]
2023-09-30 V1.1 PCB updates after initial testing 1. Share data out line between LCD, 7 Segment and button scan to yield spare io lines for control of WS8212 LEDs for music stand lamp 2. Replace level shifting 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
    [ButtonMountingBoard.kicad_pcb, ButtonMountingBoard2x3Way.kicad_pcb, ButtonMountingBoard2x3Way.kicad_sch, CombinedKS61Prototype.kicad_pcb, CombinedKS61Prototype.kicad_sch, MidiInterfaceKS61.kicad_pcb, MidiInterfaceKS61.kicad_sch, PCMountButtonDriver.kicad_pcb]
2025-04-20 Updates during initial console construction
    [MidiInterfaceKS61.kicad_sch, musicStand.dxf, test.dxf]
2025-04-21 Added expression pedal drawings
    [#PrototypeJig.dxf, Foot Pedal Drilling and Cutting.dxf, Foot Pedal Geometry.dxf, PrototypeJig.dxf]
2025-04-21 Add Maudio Keystation 61 Mk3 connector wiring and scan libreoffice document
2025-04-21 Archive midi firmware
    [Hex2Dec_2^n.ods, PortPinAssignment.ods, USBSysExEstimates.ods]
2025-04-21 Add Assembly Notes
2025-04-24 Add stm32 port bit assignments, generate pdf
2025-04-26 User interface preparation for pedalboard, adc and ws2812 support
2025-05-14 Add support for WS2812 LED strip Add support for scannned pedalboard Add support for 0-8 expression pedals Add Button LED invert feature Start UserManual.md
    [MidiFirmware.ino, USBSerialUI.cpp, USBSerialUI.h, bluepill_ws2812.cpp, bluepill_ws2812.h, buttonscan.cpp, buttonscan.h, hsvtorgb.c]
2025-05-16 Fix Metronome Tempo display
    [mymidi.cpp]
2025-05-17 ✓Disable save of J[] monitor config to avoid startup issues ✓Display 0 ADCs when not in pedalboard mode ✓Configure Velocity Disable independent from pedalboard ✓Enhancement - Dim buttons when not ful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
    [USBSerialUI.cpp, buttonscan.cpp]
2025-05-18 Improved profile feature Simple scheduler so that keyboard, buttons, lcds avoid each other in time
    [MidiFirmware.ino, USBSerialUI.cpp, buttonscan.cpp, mymidi.cpp, mymidi.h, profile.h]
2025-05-23 Buttons always scanned. Config LEDs dim/off, LEDs normal/invert check 100kHz vs 400KHz etc i2c lcd load timing 8.4ms vs 2.2ms Check button profile when midi not running vs running-Slow when GO not co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
    [USBSerialUI.cpp, USBSerialUI.h, adc.cpp, adc.h, buttonscan.cpp, buttonscan.h, mymidi.cpp, profile.cpp]
2025-05-27 Adopt multi lcd code avoiding redundant writes down to character level Remove all warnings Profile Midi out to midi in Sysex response Make start sequence more informative and responsive
    [MidiFirmware.ino, USBSerialUI.cpp, USBSerialUI.h, hsvtorgb.c, multilcd.cpp, multilcd.h, mymidi.cpp, profile.cpp]
2025-06-02 Add Button LED to Midi Event monitor Add time to event monitor Fix pin configuration display for shift registers Add PC/USB Comms to LCD start screens Disble LCDs when not configured 7 seg display ad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
    [MidiFirmware.ino, USBSerialUI.cpp, USBSerialUI.h, adc.cpp, buttonscan.cpp, buttonscan.h, keyboardscan.cpp, keyboardscan.h]
2025-06-03 Monitor Note to show middle C note 60 Octave 4, agree with midisnoop Activate up to 4 ADC inputs when Keyboard Velocity disabled Increase number of shift registers to 8
2025-06-04 LCD startup & print buffer updates
2025-06-04 Tidy up reporting of fault i2c bus Scheduler and timing offset by profile ID
2025-06-07 Investigate HID codes ready for page turning support Investigate and fix bad profile of WS2812 LED strip
    [MidiFirmware.ino, USBSerialUI.cpp, USBSerialUI.h, bluepill_ws2812.cpp, buttonscan.cpp, keyboardscan.cpp, multilcd.cpp]
2025-06-09 Fix timing discrepancy on WS2812 profile Reduce Midi channel config to 3 bits Reduce 74HC168 Config item to single 2 bit Add Page Turning control to configuration as 'H' command
    [USBSerialUI.cpp, USBSerialUI.h, buttonscan.cpp, keyboardscan.cpp, pin.h]
2025-06-13 Refactored colorwheel to WS2812Ctrl class Added status and event monitor to ws2812Ctrl Fixed profile of HID page turning
    [MidiFirmware.ino, USBSerialUI.cpp, buttonscan.cpp, hid_pt.cpp, hid_pt.h, hsvtorgb.c, keyboardscan.cpp, multilcd.cpp]
2025-06-15 Minor fixes and UserManual update
    [USBSerialUI.cpp, USBSerialUI.h, bluepill_ws2812.h, buttonscan.cpp, hid_pt.cpp, keyboardscan.cpp, ws2812ctrl.cpp, ws2812ctrl.h]
2026-10-15 1. Add Display & Button LED disable controlled by GO button LED event 63 This feature makes the organ go dark when exiting GranOrgue 2. Fix A-J commands displaying odd character when enabled in RPiOS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
