radionerd/VirtualPipeOrgan/(notices)

Notices in the files:
PCBs/MidiInterfaceAll/MidiInterface.kicad_pcb:
PC Button+LED Mounting Board V1.0 (c)2023 Richard Jones
